Robotistan/REX-8in1-V2/README.md

# What is REX 8 in 1? 🤖🔍🌟

🤖 REX is an educational robot kit developed by Robotistan R&D team. The 8in1 robot kit, with its motherboard using the ESP32 infrastructure, eliminates the difficulties encountered in circuit setup such as port and cable confusion. However, Arduino IDE, Thonny IDE, and MicroBlocks IDE provide the user with great flexibility in programming. 🛠️🔌🚀

🎛️ The REX card is a special card designed to make the mechanical and electronic installation of the robots in the 8 in 1 set more convenient. This board, which uses the ESP32E processor, has connectors to easily connect all the components used in the REX 8 in 1 set to the circuit with a single cable. 🛠️🔌🤝🔗

⚙️ 4 motor drivers and servo motors connectors to make the installation and circuit designs of 8 in 1 robots easier on the REX board, 1 connection connector for each to connect the HC-SR04, IR, and MPU6050 sensors, to connect a 9v battery to the circuit externally port and 1 buzzer and switch integrated into the card. 🛠️🔌🏎️🎛️🚀🔋🔊

🔌💡🔋🔊 Enjoy building and programming your robots with REX! Happy robot adventures! 🚀🌟🤖🎉

<div align="">
  
</div>

## Repository Contents

- ##### [Components](https://github.com/Robotistan/8in1/tree/main/Components)
   * [Line-IR Follower Sensor](https://github.com/Robotistan/8in1/tree/main/Components/Line-IR%20Follower%20Sensor)
   * [REX Pinout/Main](https://github.com/Robotistan/REX-8in1-V2/tree/main/REX%20Pinout)
   * [E-Book](https://github.com/Robotistan/REX-8in1-V2/files/12227503/QUICK.START.GUIDE.pdf)
- #### [Installation Manuals](https://github.com/Robotistan/8in1/tree/main/Installation%20Manuals)
- ##### [Robots](https://github.com/Robotistan/8in1/tree/main/Robots) 🤖
   * [ArmBot](https://github.com/Robotistan/REX-8in1-V2/tree/main/Robots%20%26%20Code/REX_Main_V5/ArmBot) 
   * [BalanceBot](https://github.com/Robotistan/REX-8in1-V2/tree/main/Robots%20%26%20Code/REX_Main_V5/BalanceBot)
   * [OmniBot](https://github.com/Robotistan/REX-8in1-V2/tree/main/Robots%20%26%20Code/REX_Main_V5/OmniBot)
   * [RoverBot](https://github.com/Robotistan/REX-8in1-V2/tree/main/Robots%20%26%20Code/REX_Main_V5/RoverBot)
   * [SonicBot](https://github.com/Robotistan/REX-8in1-V2/tree/main/Robots%20%26%20Code/REX_Main_V5/SonicBot)
   * [SumoBot](https://github.com/Robotistan/REX-8in1-V2/tree/main/Robots%20%26%20Code/REX_Main_V5/SumoBot)
   * [TrackerBot](https://github.com/Robotistan/REX-8in1-V2/tree/main/Robots%20%26%20Code/REX_Main_V5/TrackerBot)
   * [WiBot](https://github.com/Robotistan/REX-8in1-V2/tree/main/Robots%20%26%20Code/REX_Main_V5/WiBot)
- ##### [Usage of ESP32 with Arduino IDE](https://github.com/Robotistan/8in1/tree/main/Usage%20of%20ESP32%20With%20Arduino%20IDE)
   * [Troubleshooting](https://github.com/Robotistan/8in1/tree/main/Usage%20of%20ESP32%20With%20Arduino%20IDE/Troubleshooting)

| Click on the 🤖 robot images to jump to the robot's page! 🔍🚀 | Enjoy exploring the robots! 🤩🔎🤖🌟 |
|---|---|
| Resim 1 | Resim 2 |
| [Arm Bot](https://github.com/Robotistan/REX-8in1-V2/tree/main/Robots%20%26%20Code/REX_Main_V5/ArmBot) | [Omni Bot](https://github.com/Robotistan/REX-8in1-V2/tree/main/Robots%20%26%20Code/REX_Main_V5/OmniBot) |
| Resim 3 | Resim 4 |
| [Balance Bot](https://github.com/Robotistan/REX-8in1-V2/tree/main/Robots%20%26%20Code/REX_Main_V5/BalanceBot) | [Rover Bot](https://github.com/Robotistan/REX-8in1-V2/tree/main/Robots%20%26%20Code/REX_Main_V5/RoverBot) |
| Resim 5 | Resim 6 |
| [Arm Bot](https://github.com/Robotistan/REX-8in1-V2/tree/main/Robots%20%26%20Code/REX_Main_V5/ArmBot) | [Sumo Bot](https://github.com/Robotistan/REX-8in1-V2/tree/main/Robots%20%26%20Code/SumoBot) |
| Resim 1 | Resim 8 |
| [Tracker Bot](https://github.com/Robotistan/REX-8in1-V2/tree/main/Robots%20%26%20Code/REX_Main_V5/TrackerBot) | [Wi Bot](https://github.com/Robotistan/REX-8in1-V2/tree/main/Robots%20%26%20Code/REX_Main_V5/WiBot) |

<h1 align="center">Ask Me Anything! 🎉</h1>

<div align="center">
  
</div>

<p align="center">
  <b>Welcome to the Best GitHub File! This file is open for you to ask any kind of questions. Feel free to ask your questions!</b>
  <br>
  <sub>I'm looking forward to your excellent questions and inspiring answers!</sub>
</p>

<br>

## 🚀 How Can I Ask a Question?

To ask a question, follow these steps:

1. Take a general look at this project, as your question might already be answered.
2. Go to the [Issues](https://github.com/Robotistan/REX-8in1-V2/issues) section and click on the "New Issue" button.
3. Provide a descriptive title and details for your question.
4. If applicable, add tags to make it easier for others to find your question.
5. Finally, click on the "Submit New Issue" button to post your question.

## 🤖 What Type of Questions Can I Ask?

This repository is open for asking any type of questions related to the project. Here are some examples:

- How to do something?
- How can I contribute to the project?
- I found a bug, how can I report it?
- I want to propose a new feature, what should I do?

If you have any further questions or need assistance, feel free to reach out to us via email at: <a href="mehmetali.dag@robotistan.com">💌 mehmetali.dag@robotistan.com</a>

## License

* Apache License

All original source code in this repository is Copyright (C) 2022 REX/Robotistan. This source code is licensed under the Apache License 2.0 as described in the file LICENSE.
Licensed under the Apache License, Version 2.0 (the "License");
you may not use this file except in compliance with the License.
You may obtain a copy of the License at

    http://www.apache.org/licenses/LICENSE-2.0

 Unless required by applicable law or agreed to in writing, software
 distributed under the License is distributed on an "AS IS" BASIS,
 WITHOUT WARRANTIES OR CONDITIONS OF ANY KIND, either express or implied.
 See the License for the specific language governing permissions and
 limitations under the License.

<p align="center">
  animated
</p>

## Authors ve Appreciation
For Design and Development of REX GitHuB Page by;
- [@ozerngg](https://github.com/ozerngg) 
- [@mehmetalidag97](https://github.com/mehmetalidag97) 

## Note
If you have any questions, please contact technical support on our [Robotistan Community](https://community.robotistan.com/).
