Robotistan/REX-8in1-V2/REX IDE Firmware/readme.txt

+-----------------------------------------+
|            Robotistan INC - 2024        |
+-----------------------------------------+

+-----------------------------------------+
|               ENGLISH (EN)              |
+-----------------------------------------+
Welcome to the Robotistan INC flashing tool! This tool allows you to easily flash MicroPython onto your ESP32 or REX Board.

1- Connect your ESP32: Plug your ESP32 or REX Board into your computer via USB.
2- Run the uploadFirmware.bat file: Double-click the .bat file to run it.
3- Select your COM port: When prompted, type the COM port (for example: COM3).
4- The tool will automatically erase the flash and write MicroPython to your device.
	- If you see the message "Failed to get PID of a device on COM*, using standard reset sequence." 
	and dots keep appearing continuously ("...."), press and hold the "BOOT" button on your device and 
	try again to upload the firmware.
5- Once done, the process is complete!

That's it! You’re ready to start using MicroPython on your ESP32!

Important Notes:
Windows Warning: If a Windows warning appears when you run the .bat file, click More Info and then click Run Anyway to proceed with the flashing process.
COM Port not detected: If you don't see your device in the COM port list, you may need to install the CH340 driver. Run the CH341SER.EXE file and click Install to install the necessary drivers.

+-----------------------------------------+
|               TURKISH (TR)              |
+-----------------------------------------+
Robotistan INC programlama aracına hoş geldiniz! Bu araç, MicroPython'u ESP32 veya REX Board'unuza kolayca yüklemenizi sağlar.

1- ESP32'nizi bağlayın: ESP32 veya REX Board'unuzu USB aracılığıyla bilgisayarınıza takın.
2- .bat dosyasını çalıştırın: uploadFirmware.bat dosyasına çift tıklayarak çalıştırın.
3- COM portunuzu seçin: İstendiğinde, COM portunuzu yazın (örneğin: COM3).
4- Araç, flash'ı otomatik olarak silecek ve MicroPython'u cihazınıza yazacaktır.
	- Eğer "Failed to get PID of a device on COM*, using standard reset sequence." mesajını görürseniz 
	ve noktalar sürekli olarak ekranda beliriyorsa ("...."), cihazınızdaki "BOOT" tuşuna basılı tutarak 
	yazılımı tekrar yüklemeyi deneyin.
5- İşlem tamamlandığında, işlem tamamlanmış olur!

Hepsi bu kadar! Artık ESP32'nizde MicroPython kullanmaya hazırsınız!

Önemli Notlar:
Windows Uyarısı: Eğer bat dosyasını çalıştırırken bir Windows uyarısı görürseniz, Daha Fazla Bilgi kısmına tıklayın ve ardından Yine de Çalıştır seçeneğine tıklayarak işlemi devam ettirin.
COM Portu Görünmüyorsa: Cihazınızı COM portları listesinde göremiyorsanız, CH340 sürücüsünü yüklemeniz gerekebilir. CH341SER.EXE dosyasını çalıştırarak Install tuşuna basarak sürücüyü yükleyebilirsiniz.

+-----------------------------------------+
|               GERMAN (DE)               |
+-----------------------------------------+

Willkommen beim Robotistan INC Flash-Tool! Mit diesem Tool können Sie MicroPython ganz einfach auf Ihr ESP32 oder REX Board flashen.

1- **Verbinden Sie Ihr ESP32**: Schließen Sie Ihr ESP32 oder REX Board über USB an Ihren Computer an.  
2- **Führen Sie die uploadFirmware.bat-Datei aus**: Doppelklicken Sie auf die .bat-Datei, um sie auszuführen.  
3- **Wählen Sie Ihren COM-Port aus**: Wenn Sie dazu aufgefordert werden, geben Sie den COM-Port ein (z. B. COM3).  
4- Das Tool löscht automatisch den Flash und schreibt MicroPython auf Ihr Gerät.  
	- Wenn Sie die Nachricht "Failed to get PID of a device on COM*, using standard reset sequence." sehen und 
	Punkte ständig erscheinen (**"...."**), halten Sie die **"BOOT"**-Taste auf Ihrem Gerät gedrückt und 
	versuchen Sie erneut, die Firmware hochzuladen.
5- Sobald der Vorgang abgeschlossen ist, ist der Prozess abgeschlossen!

Das war's! Sie sind bereit, MicroPython auf Ihrem ESP32 zu verwenden!

Wichtige Hinweise:
Windows-Warnung: Wenn beim Ausführen der .bat-Datei eine Windows-Warnung angezeigt wird, klicken Sie auf Weitere Informationen und dann auf Trotzdem ausführen, um mit dem Flashvorgang fortzufahren.
COM-Port nicht erkannt: Wenn Sie Ihr Gerät nicht in der Liste der COM-Ports sehen, müssen Sie möglicherweise den CH340-Treiber installieren. Führen Sie die CH341SER.EXE-Datei aus und klicken Sie auf Installieren, um die erforderlichen Treiber zu installieren.

+-----------------------------------------+
|               SPANISH (ES)              |
+-----------------------------------------+

¡Bienvenido a la herramienta de flash de Robotistan INC! Esta herramienta te permite flashear fácilmente MicroPython en tu ESP32 o REX Board.

1- Conecta tu ESP32: Conecta tu ESP32 o REX Board a tu computadora a través de USB.
2- Ejecuta el archivo .bat: Haz doble clic en el archivo uploadFirmware.bat para ejecutarlo.
3- Selecciona tu puerto COM: Cuando se te pida, escribe el puerto COM (por ejemplo: COM3).
4- La herramienta borrará automáticamente el flash y escribirá MicroPython en tu dispositivo.
	- Si ves el mensaje "Failed to get PID of a device on COM*, using standard reset sequence." 
	y los puntos siguen apareciendo continuamente ("...."), mantén presionado el botón "BOOT" 
	en tu dispositivo y vuelve a intentar cargar el firmware.
5- Una vez finalizado, ¡el proceso está completo!

¡Eso es todo! ¡Estás listo para empezar a usar MicroPython en tu ESP32!

Notas Importantes:
Advertencia de Windows: Si aparece una advertencia de Windows al ejecutar el archivo .bat, haz clic en Más información y luego en Ejecutar de todos modos para continuar con el proceso de flasheo.
No se detecta el puerto COM: Si no ves tu dispositivo en la lista de puertos COM, es posible que necesites instalar el controlador CH340. Ejecuta el archivo CH341SER.EXE y haz clic en Instalar para instalar los controladores necesarios.

+-----------------------------------------+
|               FRENCH (FR)               |
+-----------------------------------------+
Bienvenue dans l'outil de flash de Robotistan INC ! Cet outil vous permet de flasher facilement MicroPython sur votre ESP32 ou REX Board.

1- Connectez votre ESP32 : Branchez votre ESP32 ou REX Board à votre ordinateur via USB.
2- Exécutez le fichier uploadFirmware.bat : Double-cliquez sur le fichier .bat pour l'exécuter.
3- Sélectionnez votre port COM : Lorsque vous êtes invité, tapez le port COM (par exemple : COM3).
4- L'outil effacera automatiquement le flash et écrira MicroPython sur votre appareil.
	- Si vous voyez le message "Failed to get PID of a device on COM*, using standard reset sequence." 
	et que des points apparaissent en continu ("...."), maintenez le bouton "BOOT" de votre appareil 
	enfoncé et réessayez de télécharger le firmware.
5- Une fois terminé, le processus est complet !

C'est tout ! Vous êtes prêt à commencer à utiliser MicroPython sur votre ESP32 !

Notes Importantes:
Avertissement Windows : Si un avertissement Windows apparaît lorsque vous exécutez le fichier .bat, cliquez sur Plus d'informations puis cliquez sur Exécuter quand même pour continuer le processus de flashage.
Port COM non détecté : Si vous ne voyez pas votre appareil dans la liste des ports COM, vous devrez peut-être installer le pilote CH340. Exécutez le fichier CH341SER.EXE et cliquez sur Installer pour installer les pilotes nécessaires.

+-----------------------------------------+
|               KAZAKH (KZ)               |
+-----------------------------------------+
Robotistan INC құралымен флеш жасауға қош келдіңіз! Бұл құрал MicroPython жүйесін ESP32 немесе REX Board құрылғыңызға оңай орнатуға мүмкіндік береді.

1- ESP32 құрылғысын қосыңыз: ESP32 немесе REX Board құрылғыңызды USB арқылы компьютеріңізге қосыңыз.
2- uploadFirmware.bat файлын іске қосыңыз: .bat файлына екі рет басып іске қосыңыз.
3- COM портыңызды таңдаңыз: Көрсетілгенде COM портын теріңіз (мысалы: COM3).
4- Құрал флешті автоматты түрде өшіріп, MicroPython-ды құрылғыңызға жазып береді.
	- Егер "Failed to get PID of a device on COM*, using standard reset sequence." 
	хабарын көрсеңіз және нүктелер үздіксіз пайда болса ("...."), құрылғыңыздағы "BOOT" 
	түймесін басып тұрып, firmware жазуды қайтадан бастаңыз.
5- Барлық процесс аяқталған соң, жұмыс аяқталды!

Бұл болды! Енді ESP32-де MicroPython қолдануға дайынсыз!

Маңызды Ескертулер:
Windows Хабарламасы: Бат файлды іске қосқан кезде Windows хабарламасы шықса, Қосымша Ақпарат-қа басыңыз және Әлі де іске қосу деп, флеш жасау процесін жалғастырыңыз.
COM портын көрмесеңіз: Құрылғыңызды COM порттар тізімінде көрмесеңіз, CH340 драйверін орнату қажет болуы мүмкін. CH341SER.EXE файлын іске қосып, Install түймесін басу арқылы драйверді орнатуға болады.

+-----------------------------------------+
|               TURKMEN (TM)              |
+-----------------------------------------+
Robotistan INC flashlama gurallaryna hoş geldiňiz! Bu gural, MicroPython'y ESP32 ýa-da REX Board'ınıza aňsatlyk bilen ýazyp biler.

1- ESP32'nizi baglaň: ESP32 ýa-da REX Board'yňyzy USB arkaly kompýuteriňize baglaň.
2- uploadFirmware.bat faýlını işlediň: .bat faýlanyň üstüne iki gezek basyp işlediň.
3- COM portunuzu saýlaň: Soňra COM portuňyzy ýazmagyňyzy haýyş edýäris (mysal üçin: COM3).
4- Gural flash'ı awtomatiki arassalar we MicroPython'u enjamyňyza ýazýar.
	- Eger "Failed to get PID of a device on COM*, using standard reset sequence." habaryny görseňiz 
	we nokatlar yzygiderli peýda bolsa ("...."), enjamyňyzdaky "BOOT" düwmesini basyp, 
	programma ýazmagy täzeden synanyşyp bilersiňiz.
5- Tamamlandy, işiňiz tamam!

Şeýle! Indi ESP32-de MicroPython ulanmak üçin taýýar!

Eýranly Notlar:
Windows Uýarmasy: Eger bat faýlını işlediýän wagtyňyz Windows uýarmasy ýüze çyksa, Has giňişleýin maglumat-a basyň we Halaçyla işlediň diýip, işlemi dowam etdiriň.
COM Porty Görünmese: Cihazyňyzy COM portlary sanawynda görmeseňiziň sebäbi CH340 sürücüsini yüklemek gerek bolup biler. CH341SER.EXE faýlını işlediň we Install düwmesine basyp sürüjini yükleýşiňizi dowam etdiriň.
