Robotistan/REX-8in1-V2/Robots & Code/README.md

rex_version
