Robotistan/REX-8in1-V2/PicoBricksGo App/README.md

# PicoBricks Go App
app _qr_kodlar
* When you select the "REX 8 in 1" option from the main menu, you will be directed to this menu where the list of REX robots is displayed. From this menu, you can choose the REX robot you want to use.
menu1
* You can use this button to control the Wi-Bot.

menu2
* You can use this button to control the OmniBot.

menu3

* You can use this button to control the ArmBot.

menu7

* REX 8in1 gamepad screen.

menu12

* Click this button to access the REX consoles.

menu4

* You can use this button to return to the previous menu.

menu5

* You can use this button to disconnect or connect.

menu6

* You can use this button to reset the robotic arm's servo motors (bring them to their default angles).

menu10

* You can use this button to activate the buzzer on the REX board and emit an audible alert (horn).

menu9

* If you want to control the REX using a joystick, you can use this area.

menu8

* You can use this area to control the robotic arm's servo motors.

menu11
