Robotistan/REX-8in1-V2/Robots & Code/REX_Main_V5/BalanceBot/README.md

## BalanceBot
BalanceBot is a special robot that can stay in balance despite physical interventions thanks to the acceleration sensor on the REX board. You can use BalanceBot in situations where you need to carry objects in balance.

<p align="center">
  animated
</p>
