Robotistan/REX-8in1-V2/Robots & Code/REX_Main_V5/WiBot/README.md

## WiBot

<p align="center">
  animated
</p>

WiBot is a REX 8 in 1 robot that does not contain any extra sensors for autonomous driving and allows only remote control. After completing the installation of WiBot, you will not have any difficulties in the circuit setup. After connecting the 4 connector cables required for the motor to the REX board, you can perform tasks that require remote control by using the electronic features of the REX board and the mechanical features of the WiBot without adding any extra sensors to the circuit.
