Robotistan/REX-8in1-V2/Robots & Code/REX_Main_V5/OmniBot/README.md

# OmniBot

<p align="center">
  animated
</p>

Thanks to its special omni wheels, OmniBot provides easy access to every point without making any rotational movement. Using OmniBot, you can reach hard-to-reach any points very easily. This robot is designed to reach hard-to-reach spots.

<p align="center">
  animated
</p>

Omni wheels combines the freedom of 360 degree movement with the stability of a fixed mounting. This is achieved through a design which uses integral rollers rather than a swivel mount. 
In this way, OmniBot provides advantages such as 360° maneuverability, better directional control-following and precise positioning.
