Robotistan/REX-8in1-V2/Robots & Code/REX_Main_V5/TrackerBot/README.md

## TrackerBot

<p align="center">
  animated
</p>

Thanks to the TrackerBot line follower sensor, it emits infrared lights and follows the black lines in the environment. We can autonomously enable TrackerBot to perform the tasks we want by using the mechanical features of the TrackerBot on the path we have created with lines. We can also change the color of the line TrackerBot follows by making changes to the code. In order to make this change, we can examine the values detected by the infrared sensor, determine the required value range for the color we want, and change these values in the code.
