Robotistan/REX-8in1-V2/Robots & Code/REX_Main_V5/SumoBot/README.md

## SumoBot
<p align="center">
  animated
</p>
Thanks to its HC-SR04 distance sensor and line follower sensor, SumoBot detects other objects on the track it is in. Thanks to its line-following sensor, SumoBot detects whether it is inside the track and in this way carries the objects off the track.
