Robotistan/REX-8in1-V2/Robots & Code/REX_Main_V5/SonicBot/README.md

## SonicBot

<p align="center">
  animated
</p>

SonicBot detects objects by emitting sound waves around it thanks to the distance sensor on it and can perform different functions by using its mechanical properties according to the values it senses. You can avoid obstacles by using SonicBot. You can use SonicBot for tasks that require you to detect objects in the environment.
