Robotistan/REX-8in1-V2/Usage of ESP32 With Arduino IDE/README.md

## Usage of ESP32 With Arduino IDE
Because of its high processing power and useful functions, ESP32 is highly preferred among many microcontrollers and development boards. Let's learn how to use ESP32 and install the ESP32 library.

## Installing ESP32 in Arduino IDE
To install the ESP32 board in your Arduino IDE, follow the steps below.

- In Arduino IDE, go to File>Preferences



- Type the following into the "Additional Board Manager URLs" field

 | https://raw.githubusercontent.com/espressif/arduino-esp32/gh-pages/package_esp32_index.json |
 | ------------------------------------------------------------------------------------------- |

Untitledd

- Click the Boards Manager

arduinoboard

- Install ESP32 by clicking install button after searching for ESP32. It'll be ready in a few seconds.

ardubo

## Let's Test The Installation
Plug your ESP32 board to your computer after you open Arduino IDE and follow steps below.
- ##### Step 1

boarddoit

- ##### Step 2

ardcom

- ##### Step 3

ardexam

- ##### A new sketch opens in your Arduino IDE.

S

- ##### Press the Upload button
- ##### If everything went as expected, we'll see “Done uploading” message.

Screenshotfsdf 2023-02-09 141242

- ##### Open the Arduino IDE Serial Monitor at a baud rate of 115200.
