Robotistan/REX-8in1-V2/(threads)

Thread 1 (2025-01-09):

BalanceBot wont work

patchido, 2025-01-09:
So i built the balancebot, after that ran the calibration code and got the offsets.

and when uploading the code v4 and even v5 the serial monitor stays at

`DMP ready! Waiting for first interrupt...`

And wont do more.

serhankoral, 2025-02-21:
Will uou solve this problem?

Thread 2 (2025-04-06):

Dc motorlar çalışmıyor

dursunonat, 2025-04-06:
Merhaba, armbot kurulumu yaptım 2 gündür uğraşıyorum. Robot kol çalışıyor fakat dc motorlar çalışmıyor. Sorun nerde olabilir

serdardmrrr, 2025-05-19:
ESP32 KARTININ MODELİNİ 2.0.11 e çek öyle düzelicek
