Robotistan/REX-8in1-V2/Installation Manuals/TrackerBot.pdf

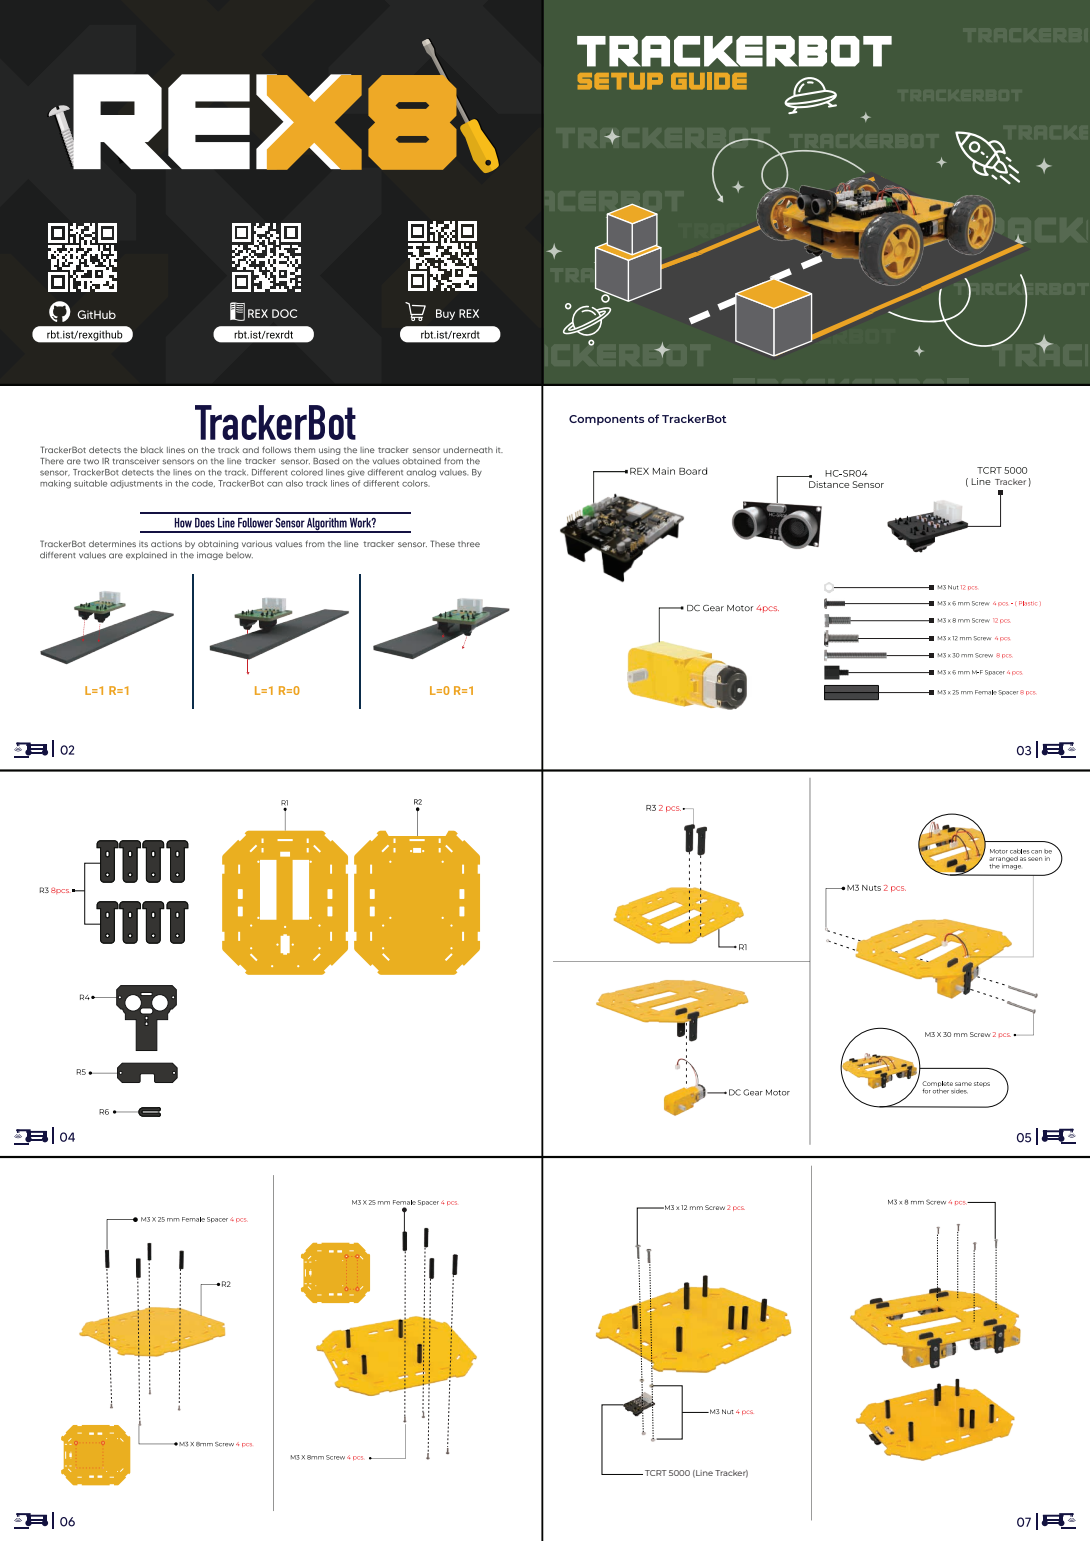
[picture p1: page 1]
tracker; Tracker

TCRT 5000 (Line Tracker)

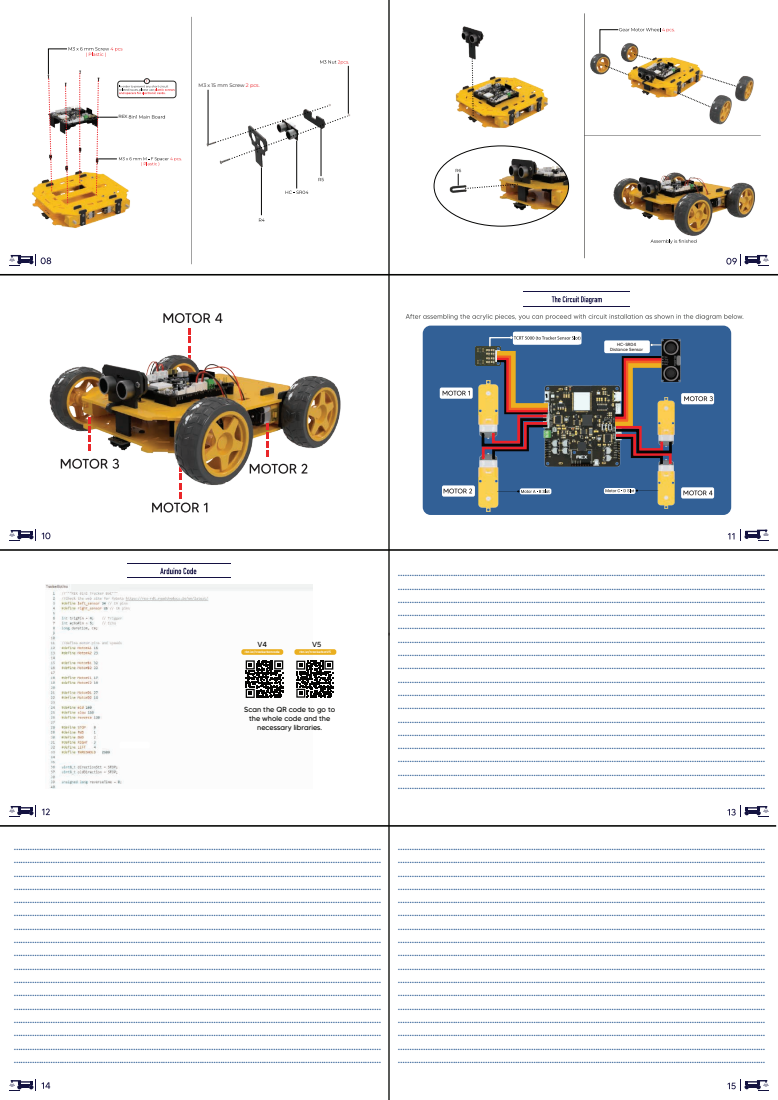
[picture p2: page 2]
HC-SR04 Distance Sensor; REX; rbt.ist/trackerbotcode; rbt.ist/trackerbotV5

M3 x 15 mm Screw 2 pcs.

Scan the QR code to go to
the whole code and the
necessary libraries.
