Robotistan/REX-8in1-V2/Installation Manuals/8in1_add_on.pdf

### 8n1 Add-on package ( Sumo & Tracker )

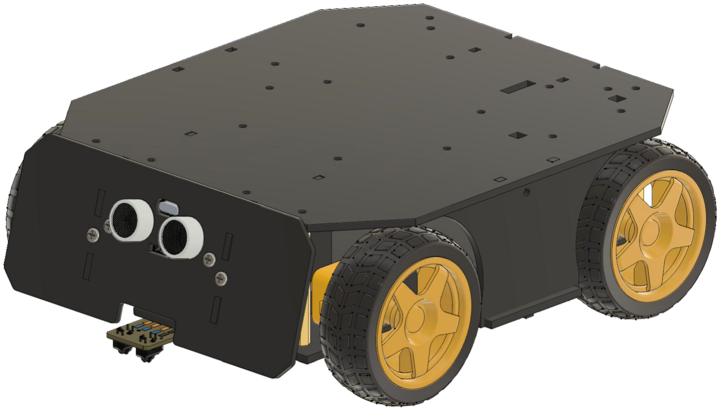
[picture p3: figure]
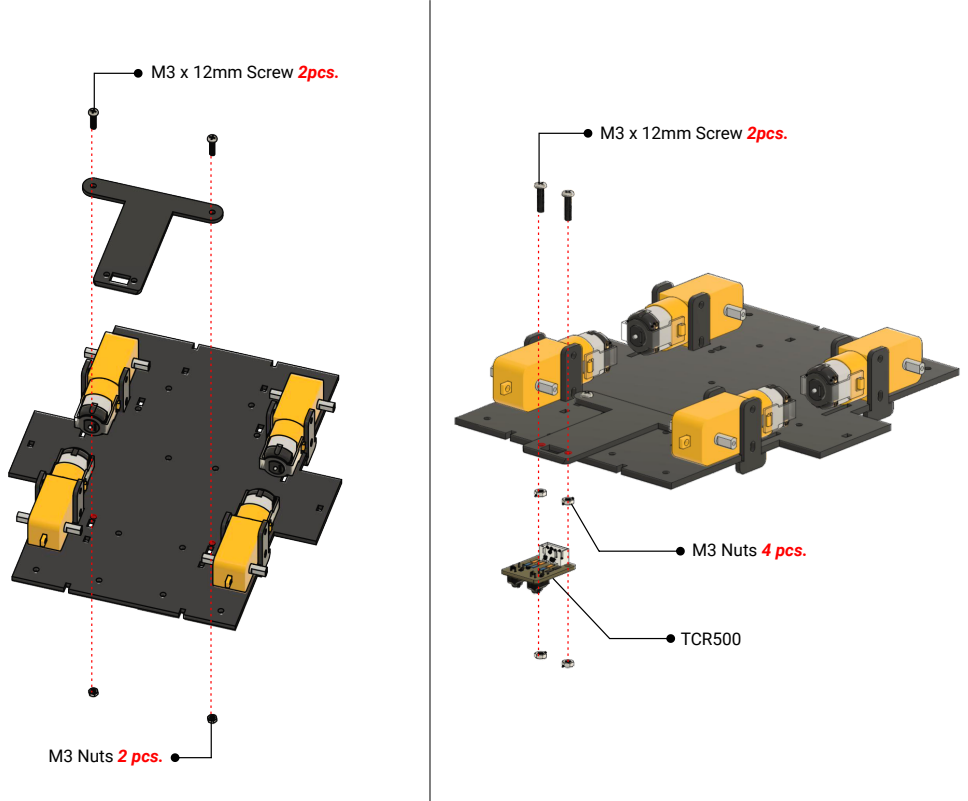
[picture p4: page 2]
M3 x 12mm Screw 2pcs.; M3 Nuts 2 pcs.; TCR500; M3 Nuts 4 pcs.

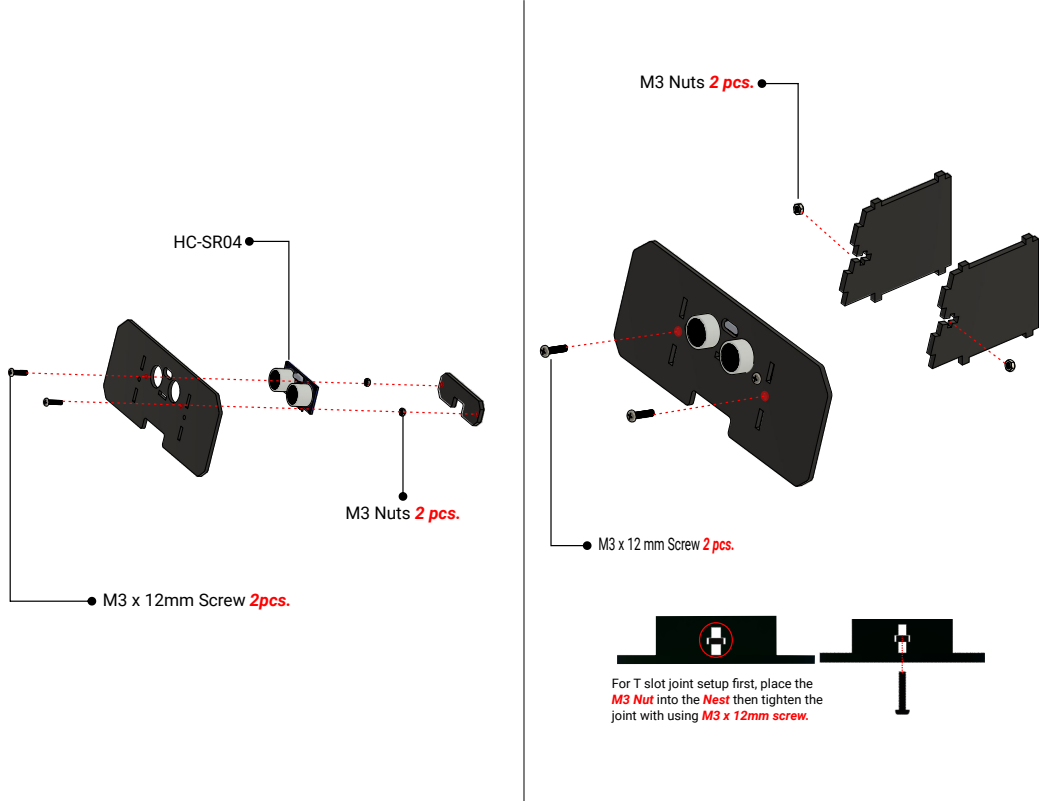
[picture p5: page 3]
M3 Nuts 2 pcs.; M3 x 12mm Screw 2pcs.

M3 x 12 mm Screw 2 pcs.

For T slot joint setup first, place the
M3 Nut into the Nest then tighten the
joint with using M3 x 12mm screw.

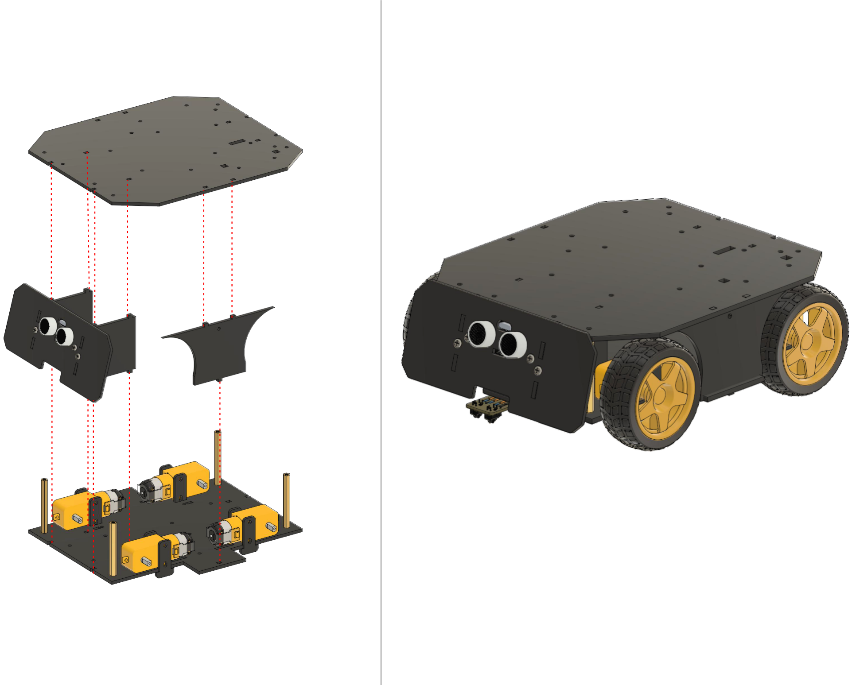
[picture p6: page 4]
