Robotistan/REX-8in1-V2/Installation Manuals/Installation-of-Omni-Wheel.pdf

# OMNI Wheel

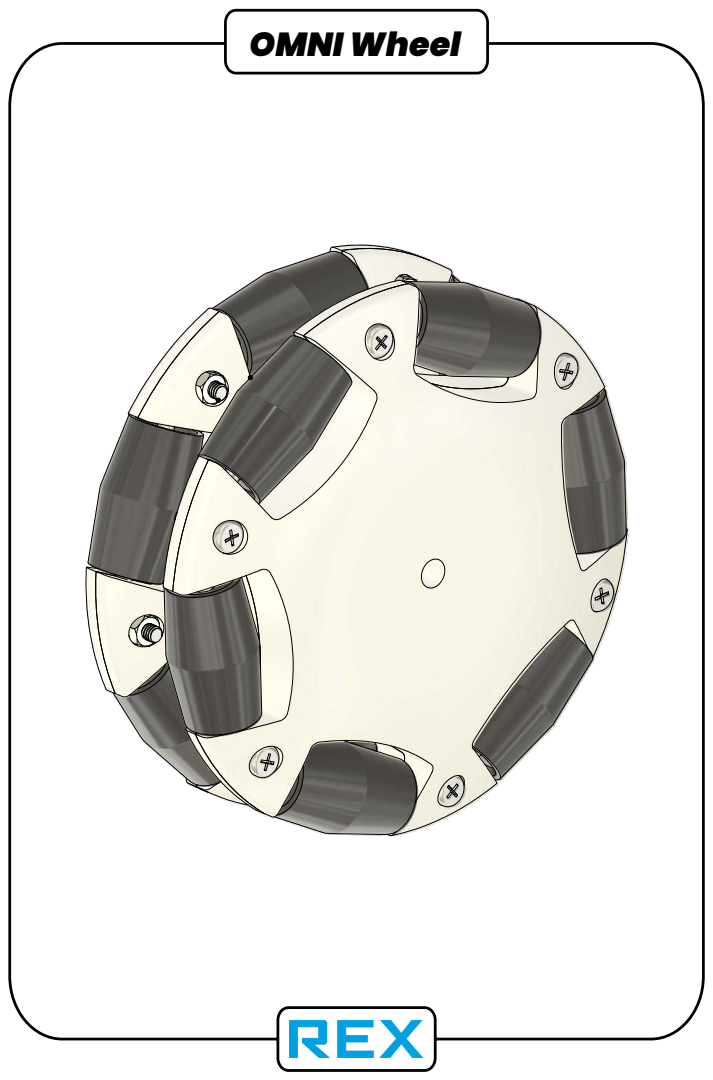
[picture p7: page 1]

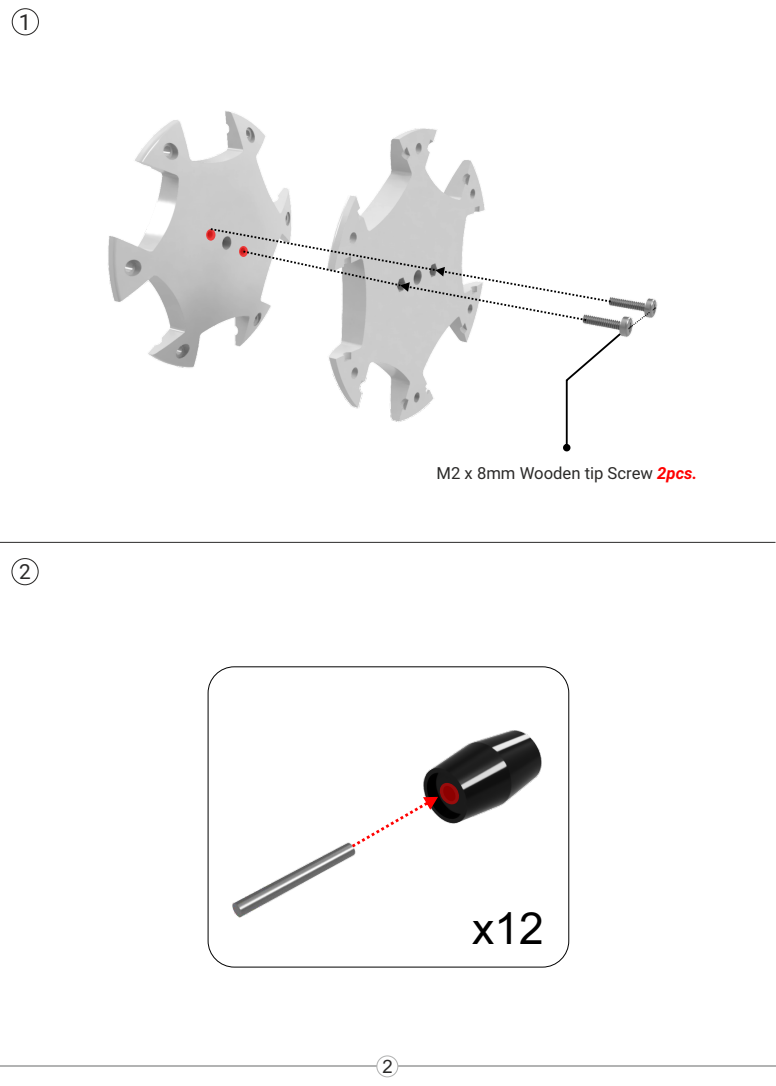
[picture p8: page 2]

M2 x 8mm Wooden tip Screw 2pcs.

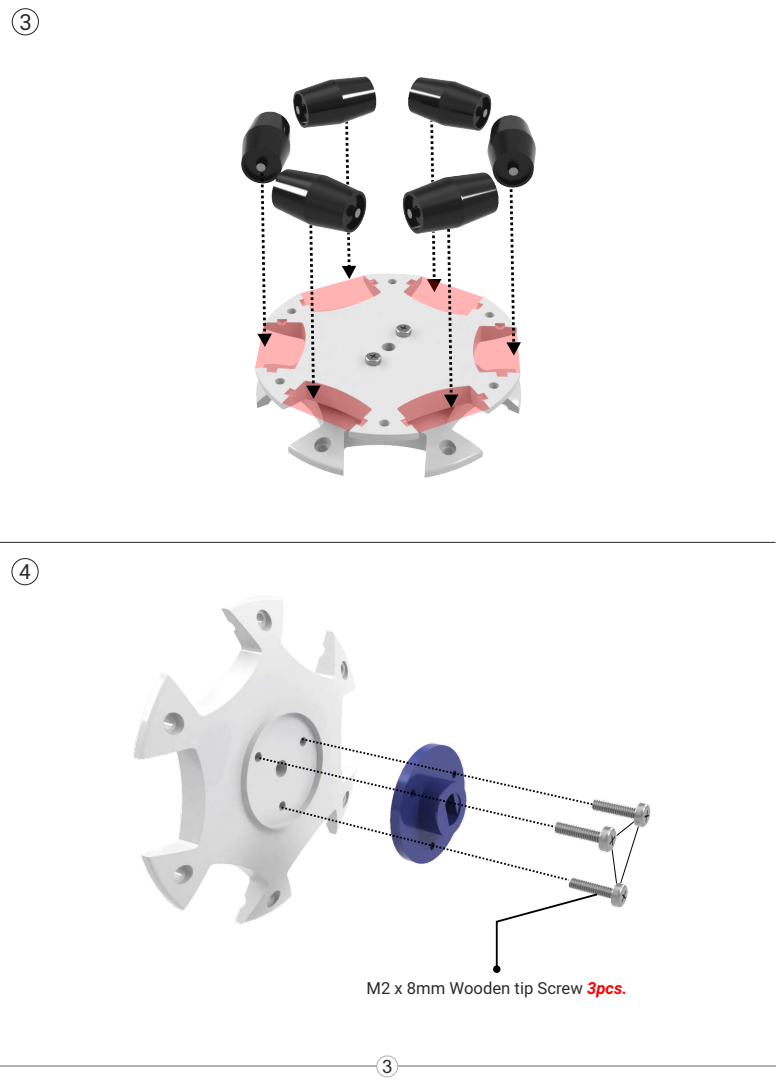
[picture p9: page 3]

M2 x 8mm Wooden tip Screw 3pcs.

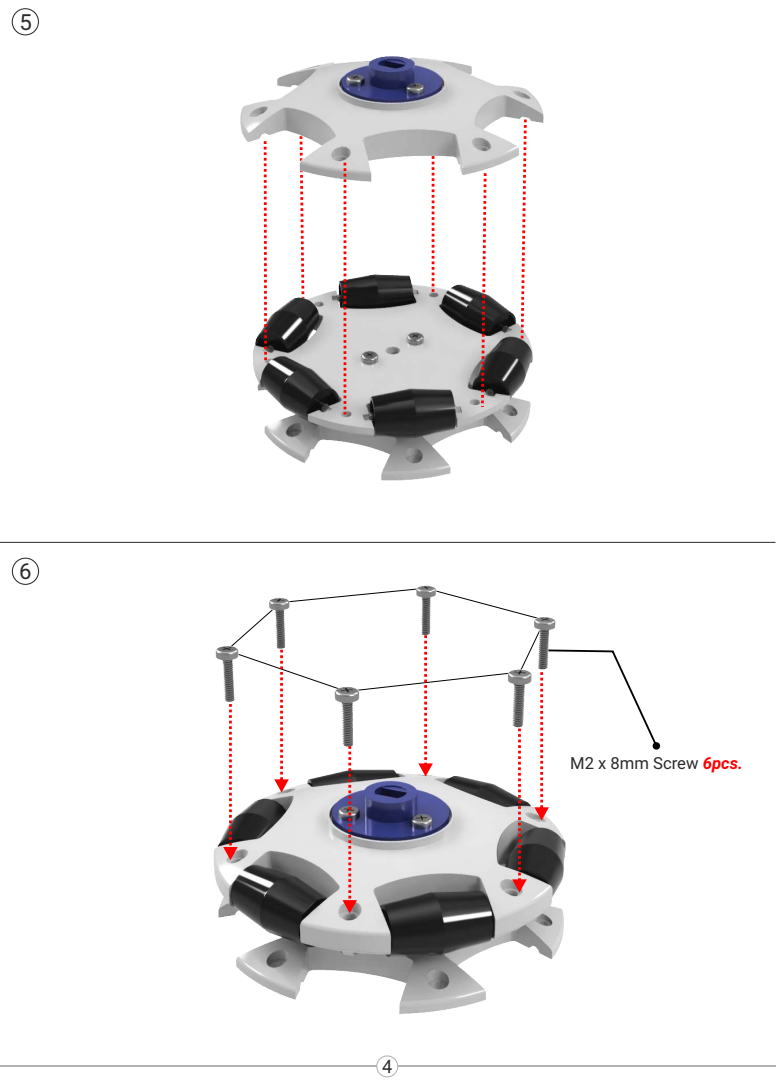
[picture p10: page 4]
M2 x 8mm Screw 6pcs.

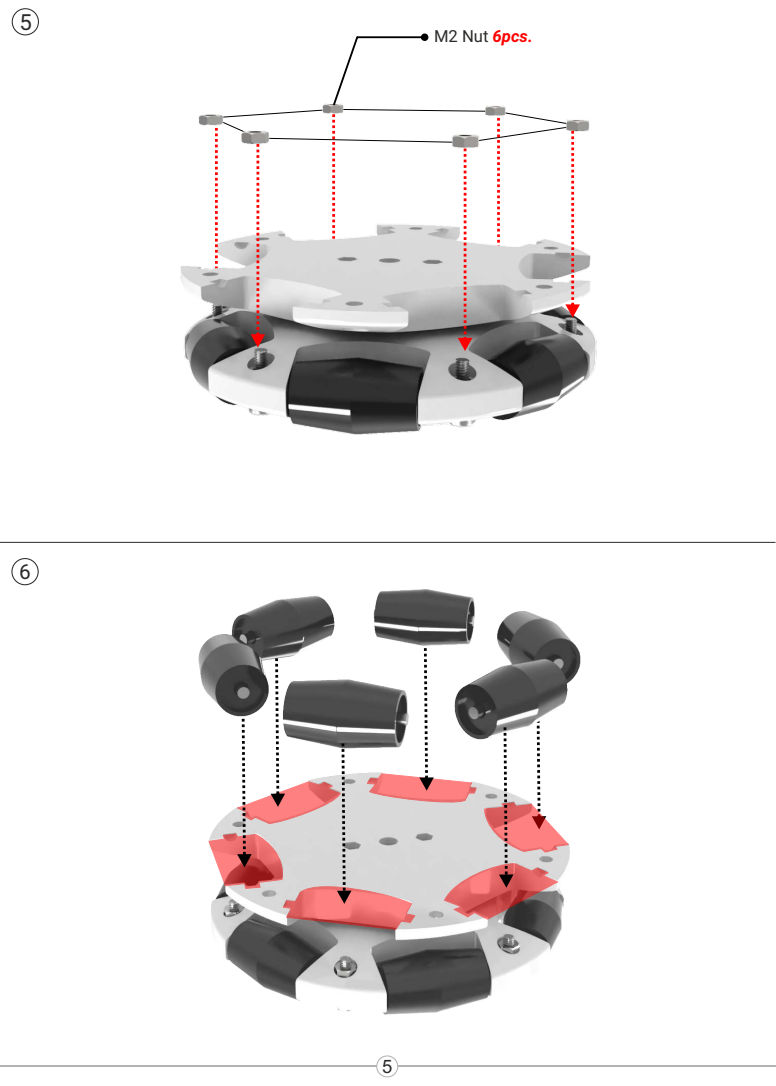
[picture p11: page 5]
M2 Nut 6pcs.

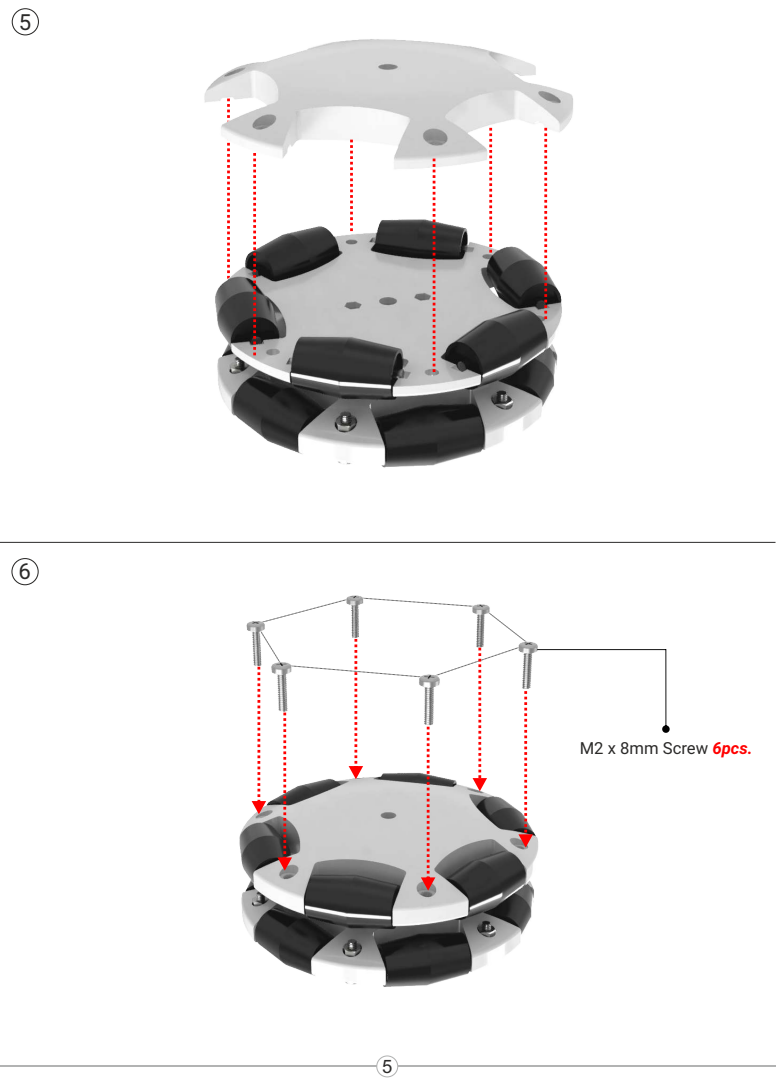
[picture p12: page 6]
M2 x 8mm Screw 6pcs.

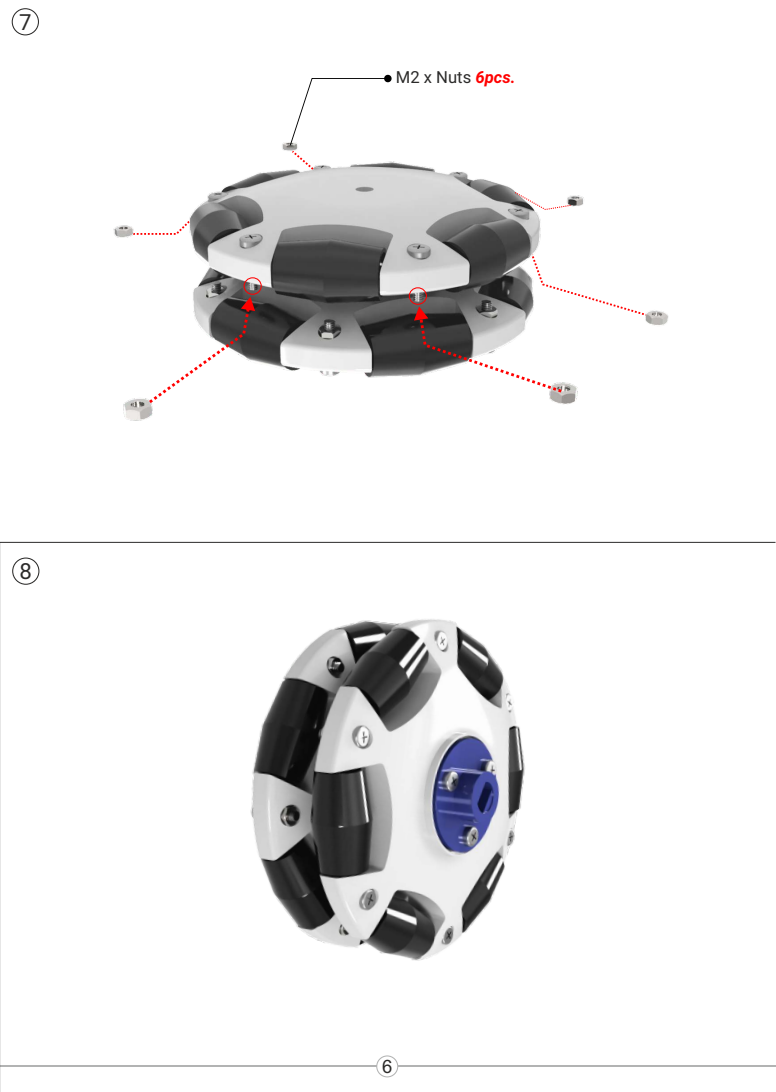
[picture p13: page 7]
M2 x Nuts 6pcs.
