Robotistan/REX-8in1-V2/Installation Manuals/BalanceBot.pdf

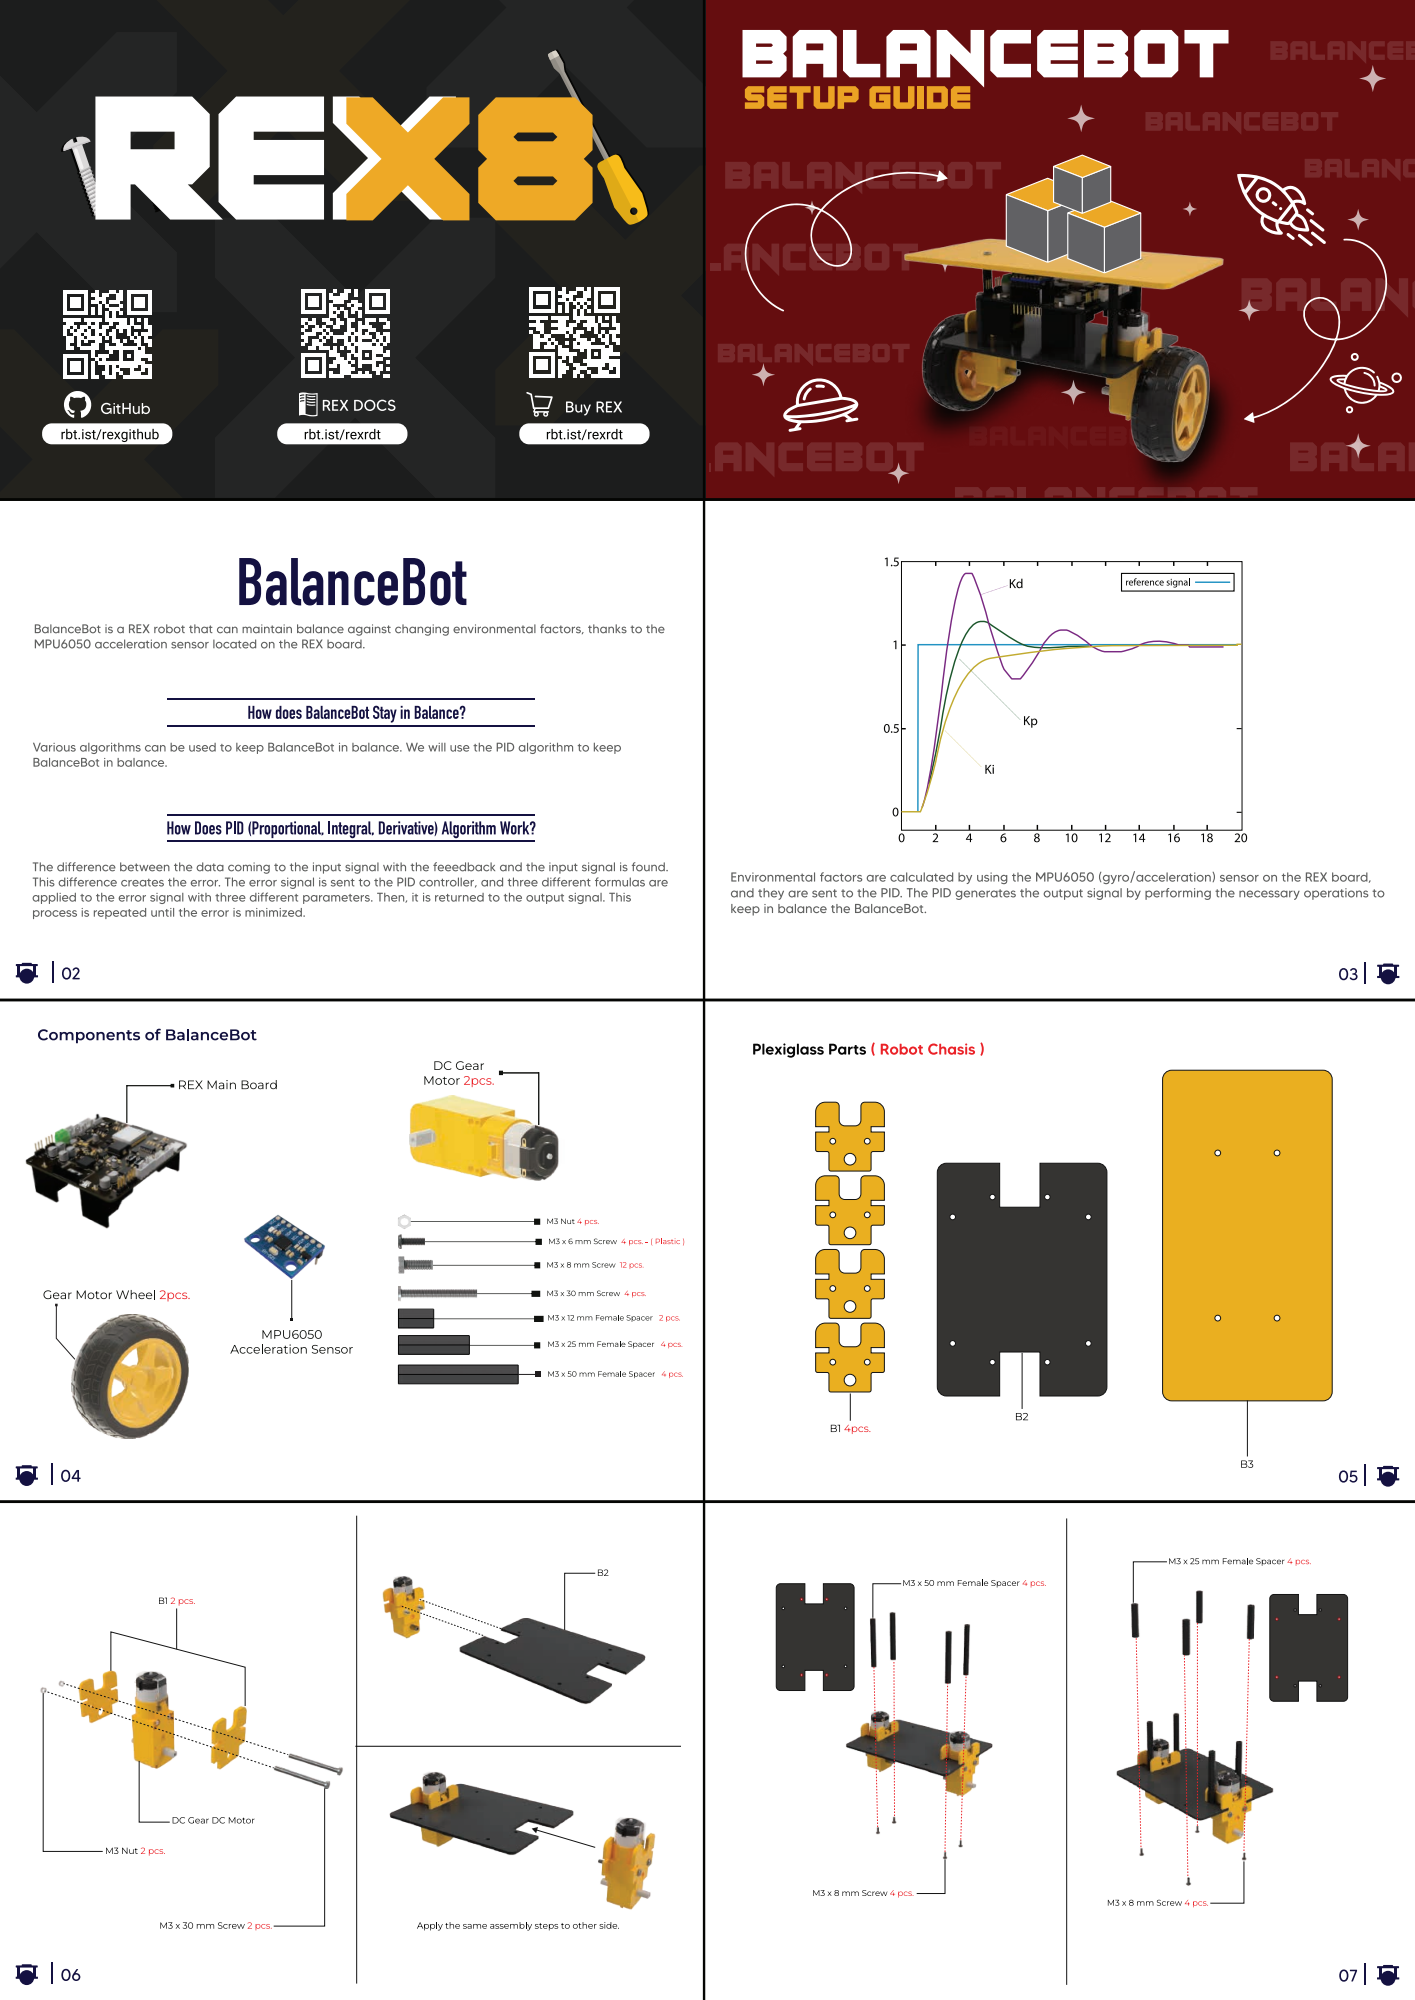
[picture p18: page 1]

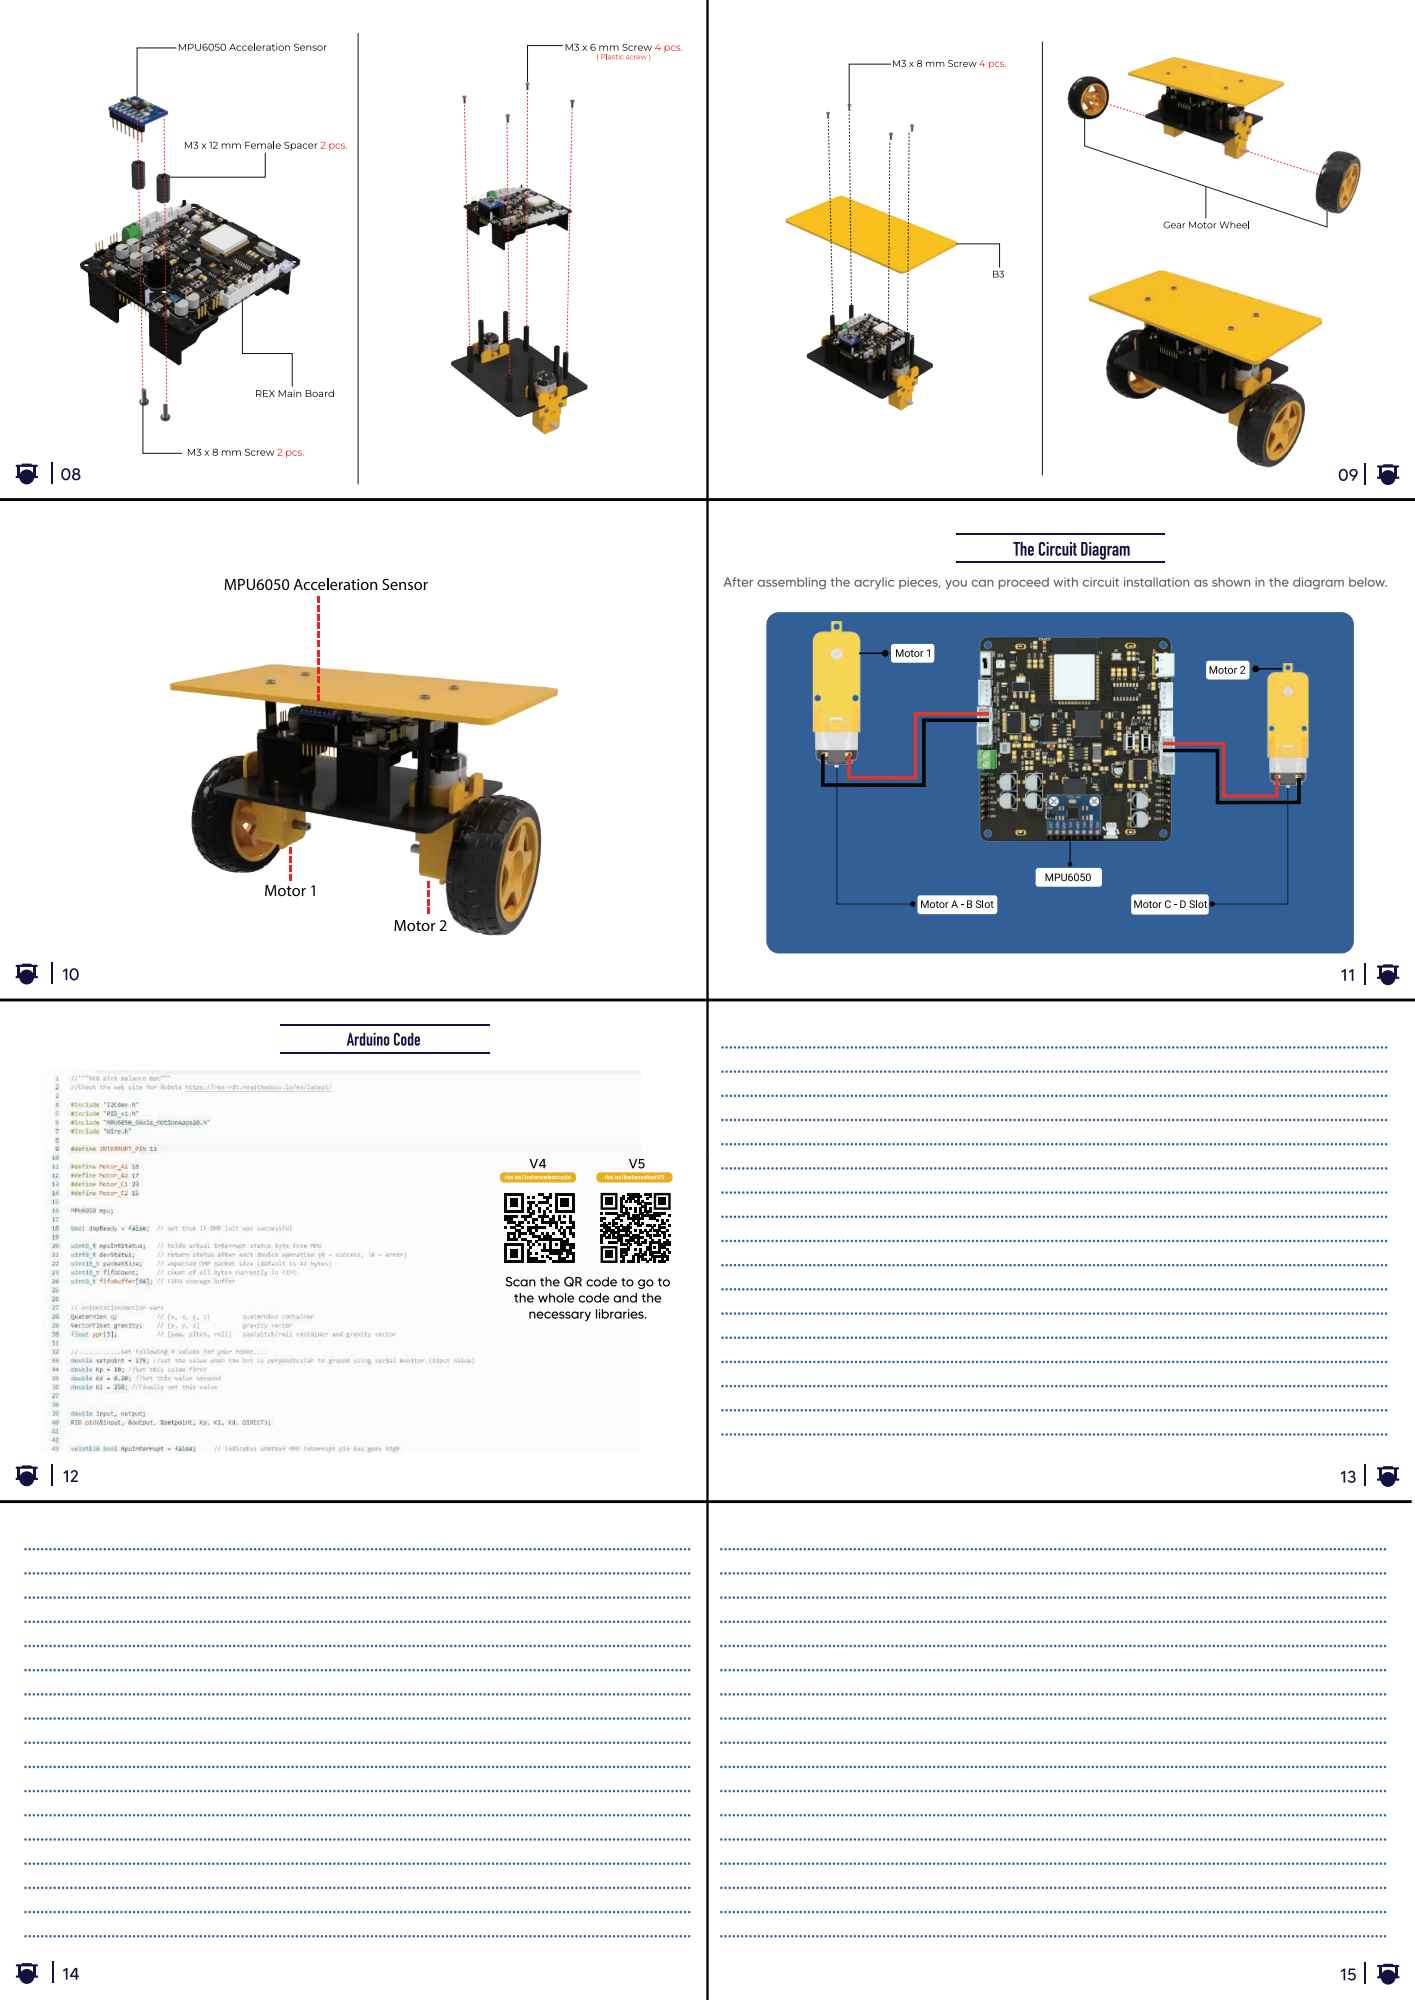
[picture p19: page 2]
