Robotistan/REX-8in1-V2/Installation Manuals/OmniBot.pdf

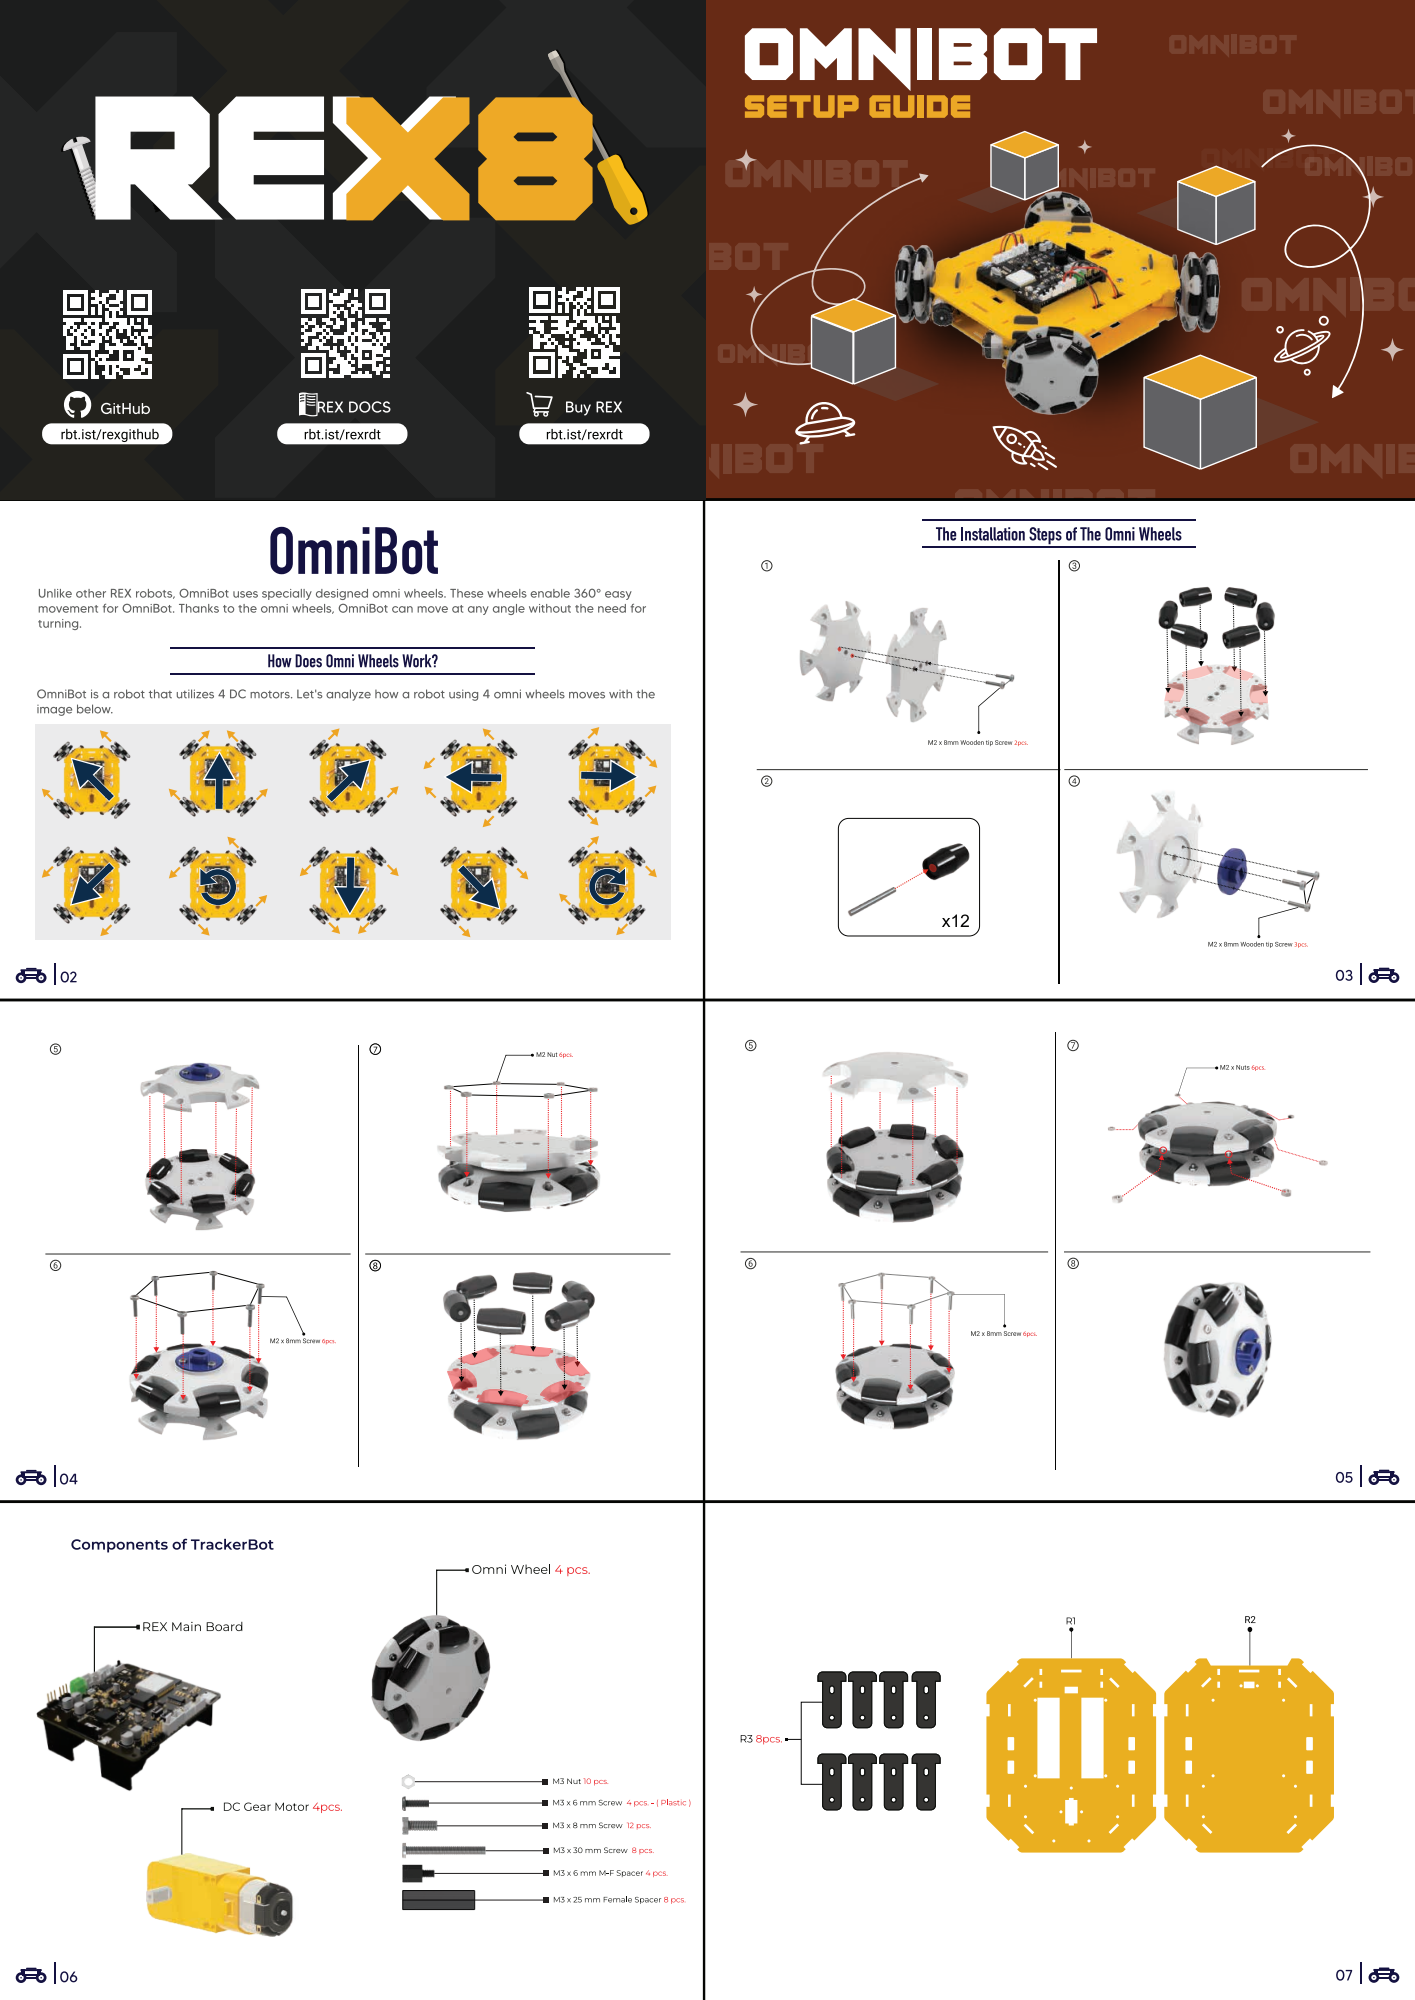
[picture p20: page 1]

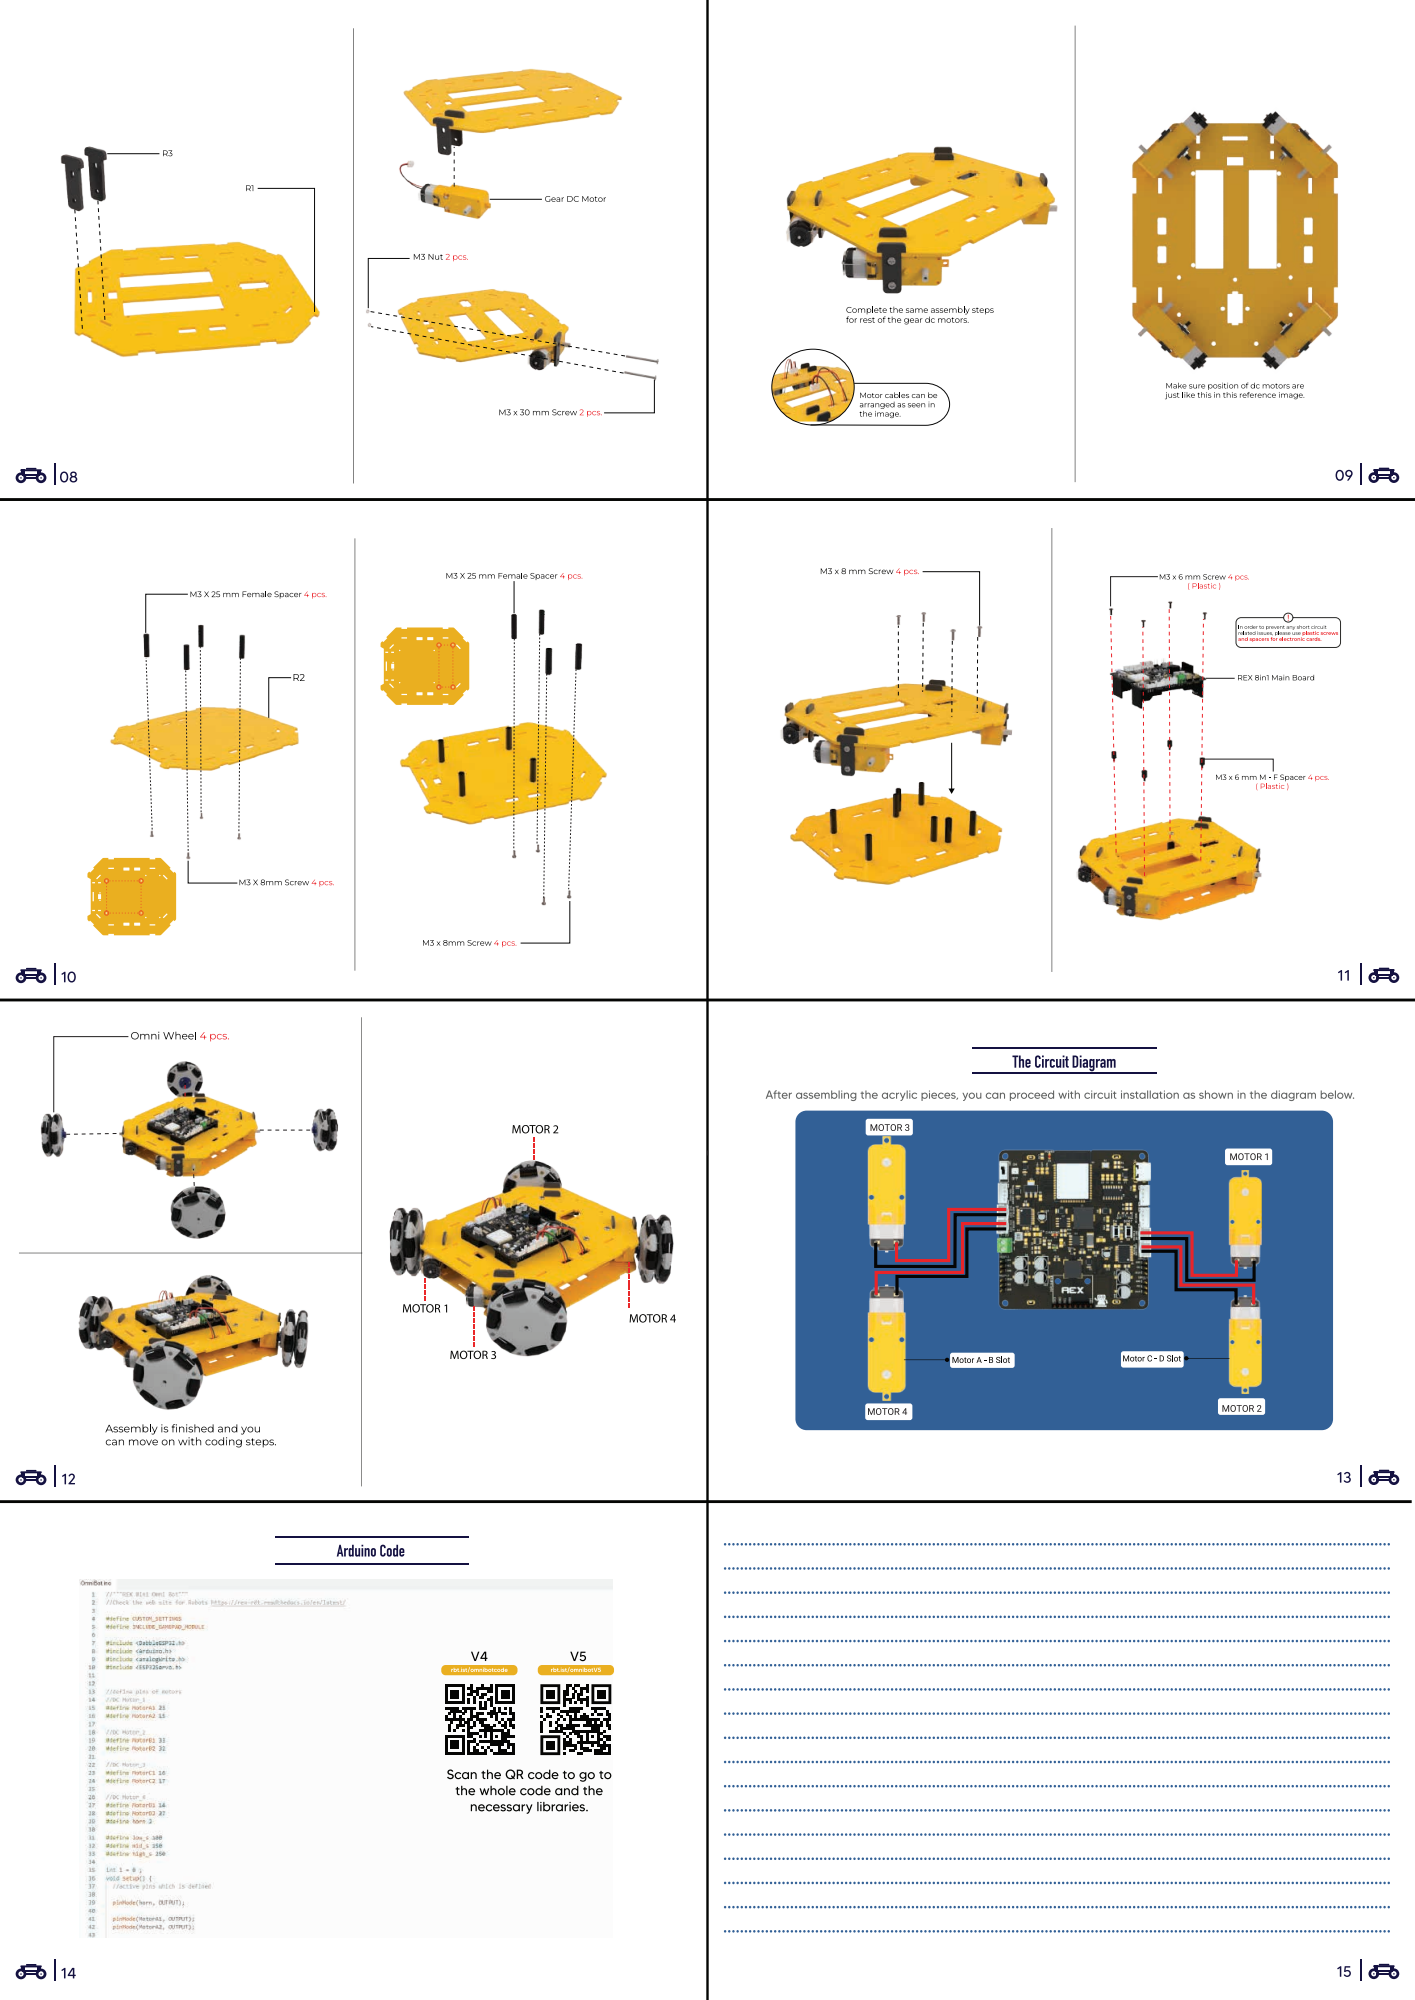
[picture p21: page 2]
