Robotistan/REX-8in1-V2/Installation Manuals/REX QUICK STARTER GUIDE.pdf

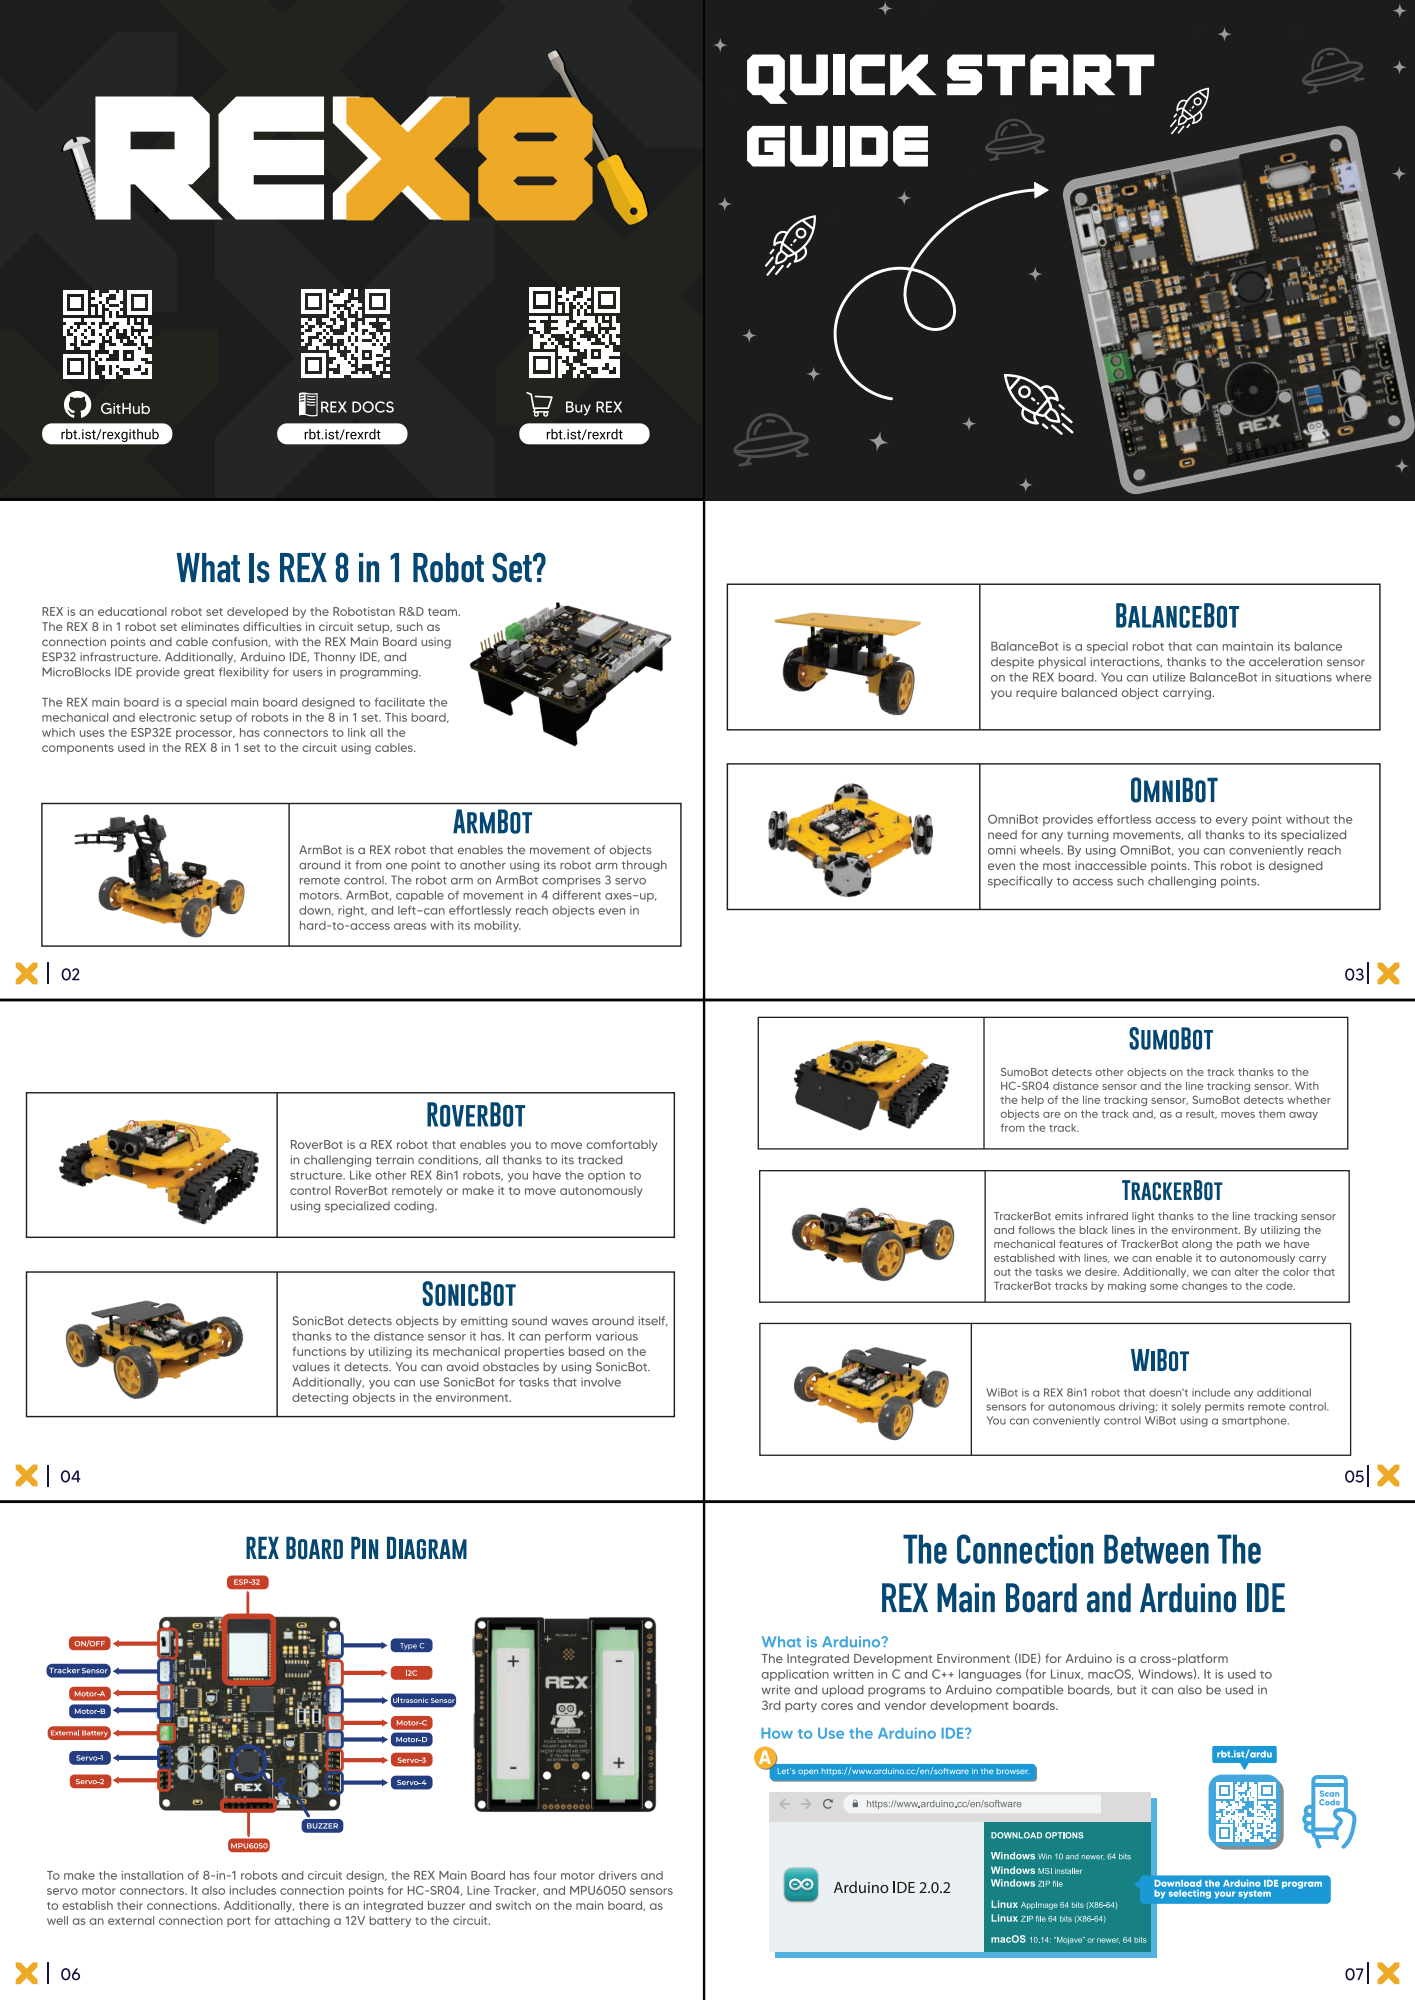
[picture p22: page 1]

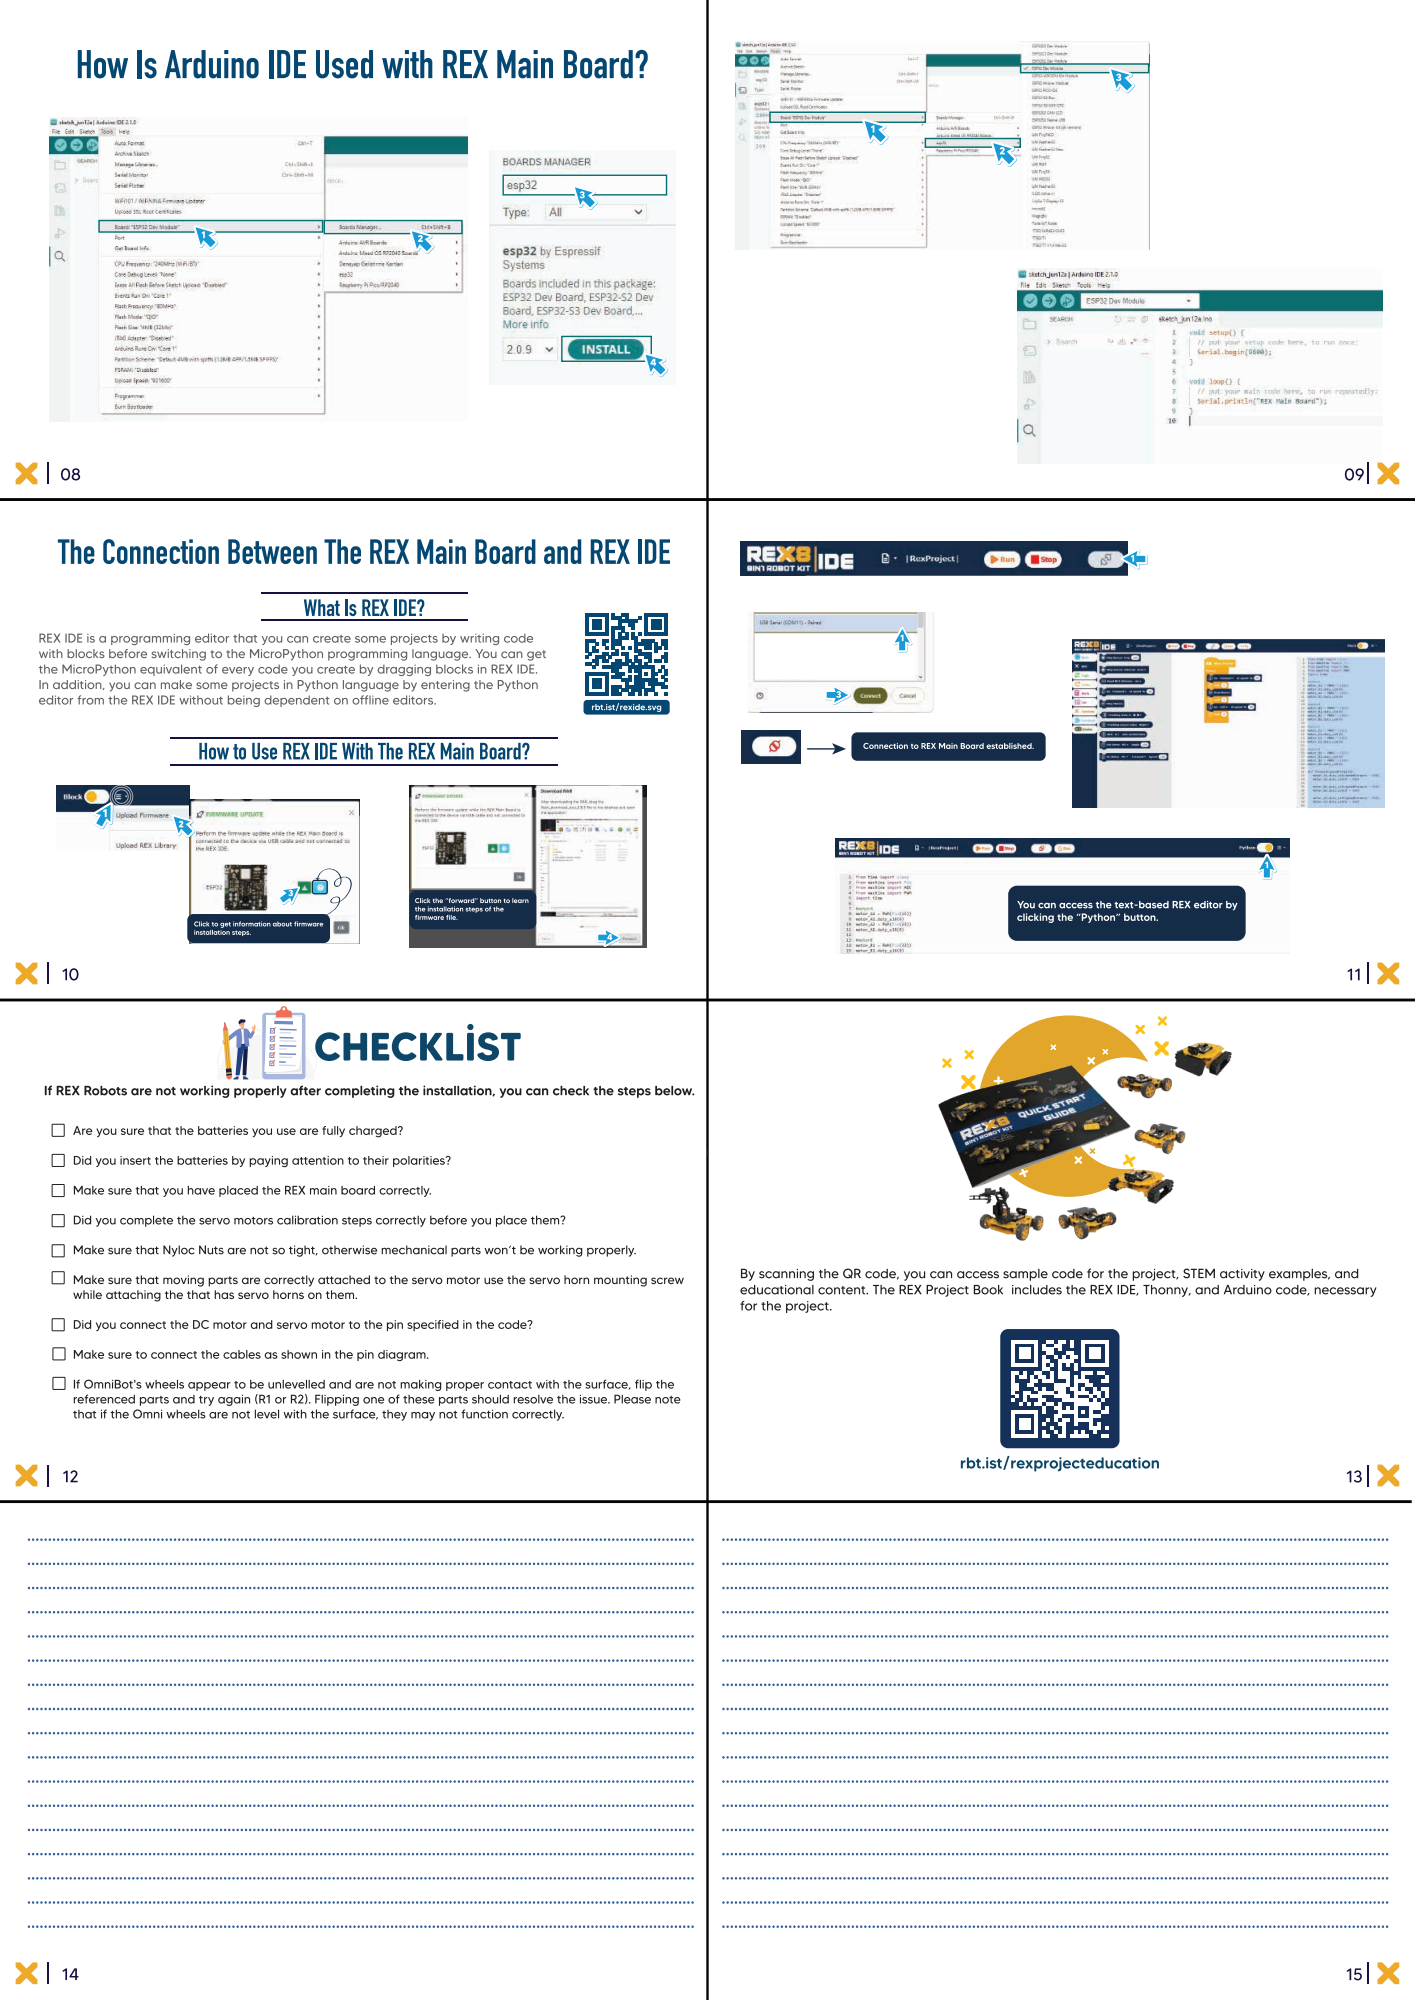
[picture p23: page 2]
