Robotistan/REX-8in1-V2/Installation Manuals/RoverBot.pdf

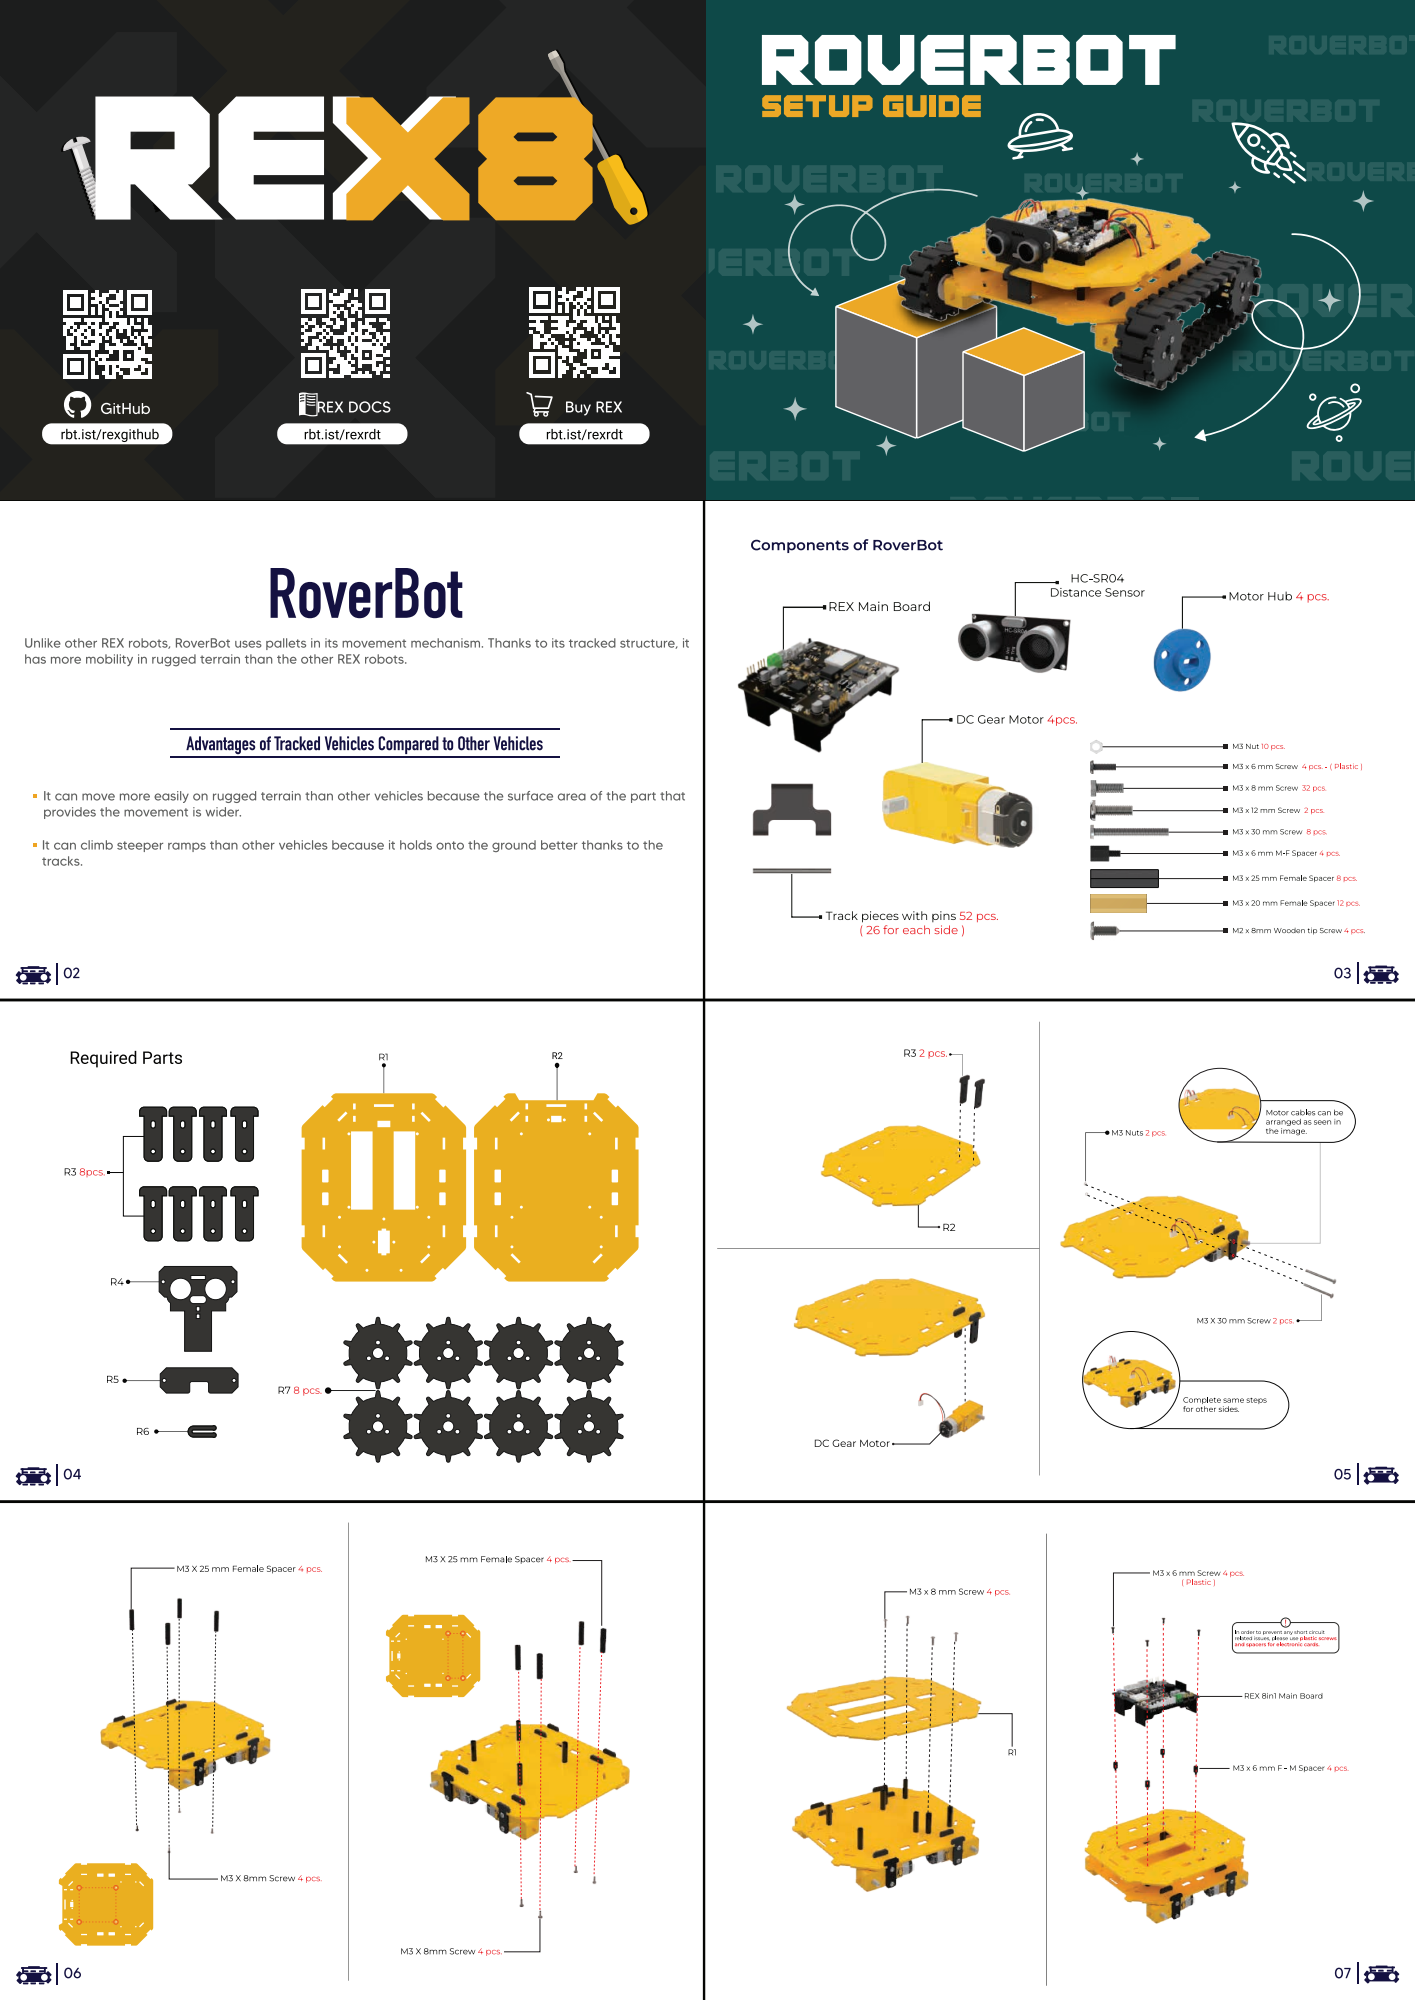
[picture p24: page 1]

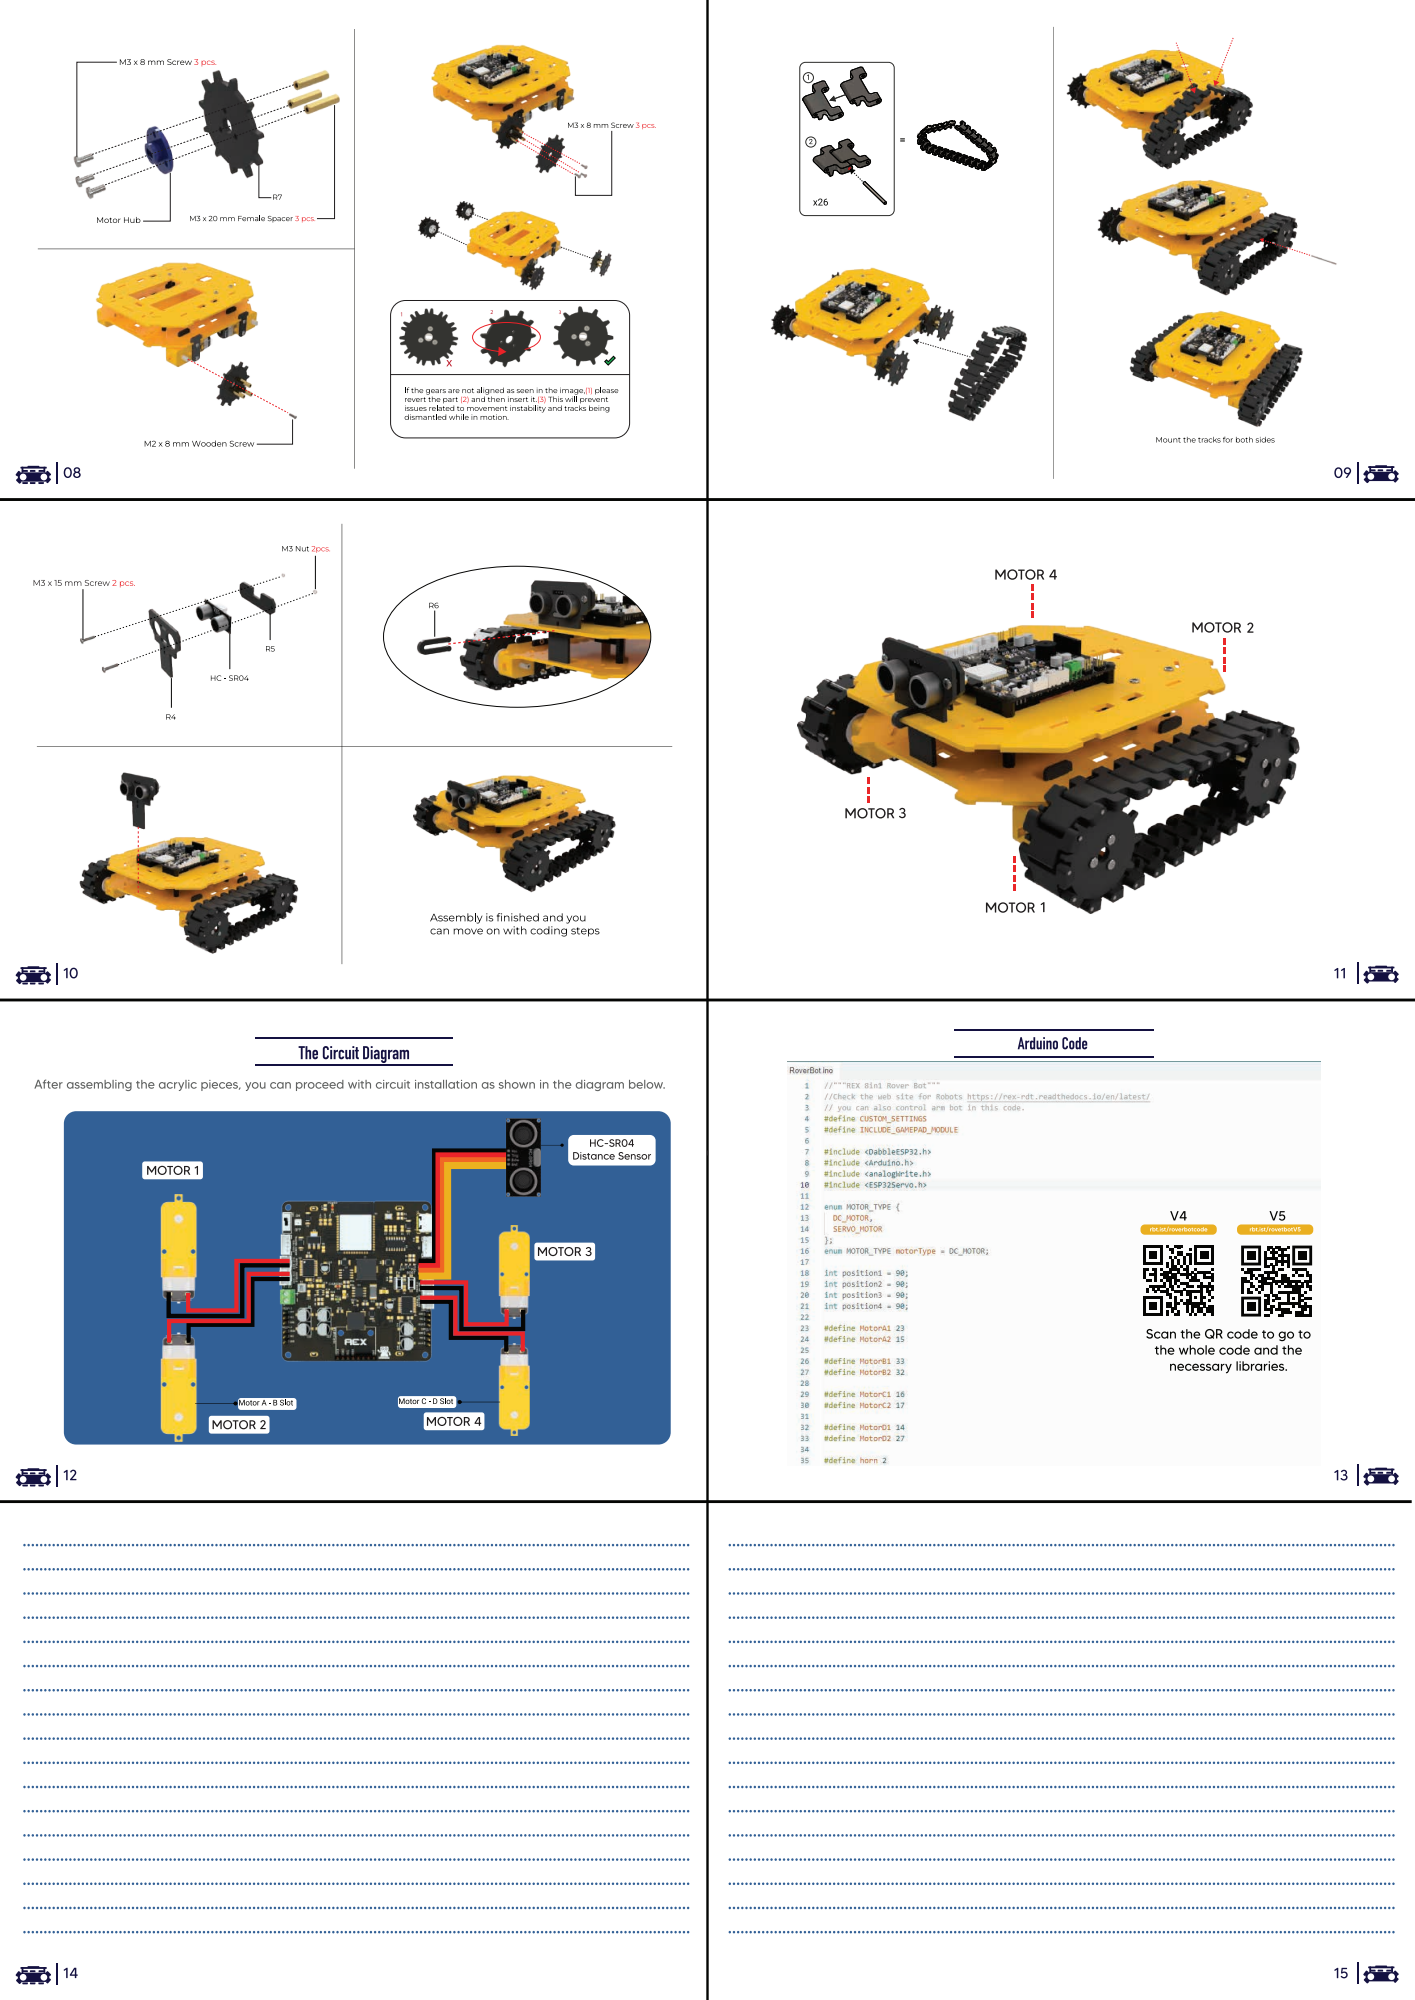
[picture p25: page 2]
