Robotistan/REX-8in1-V2/Installation Manuals/SonicBot.pdf

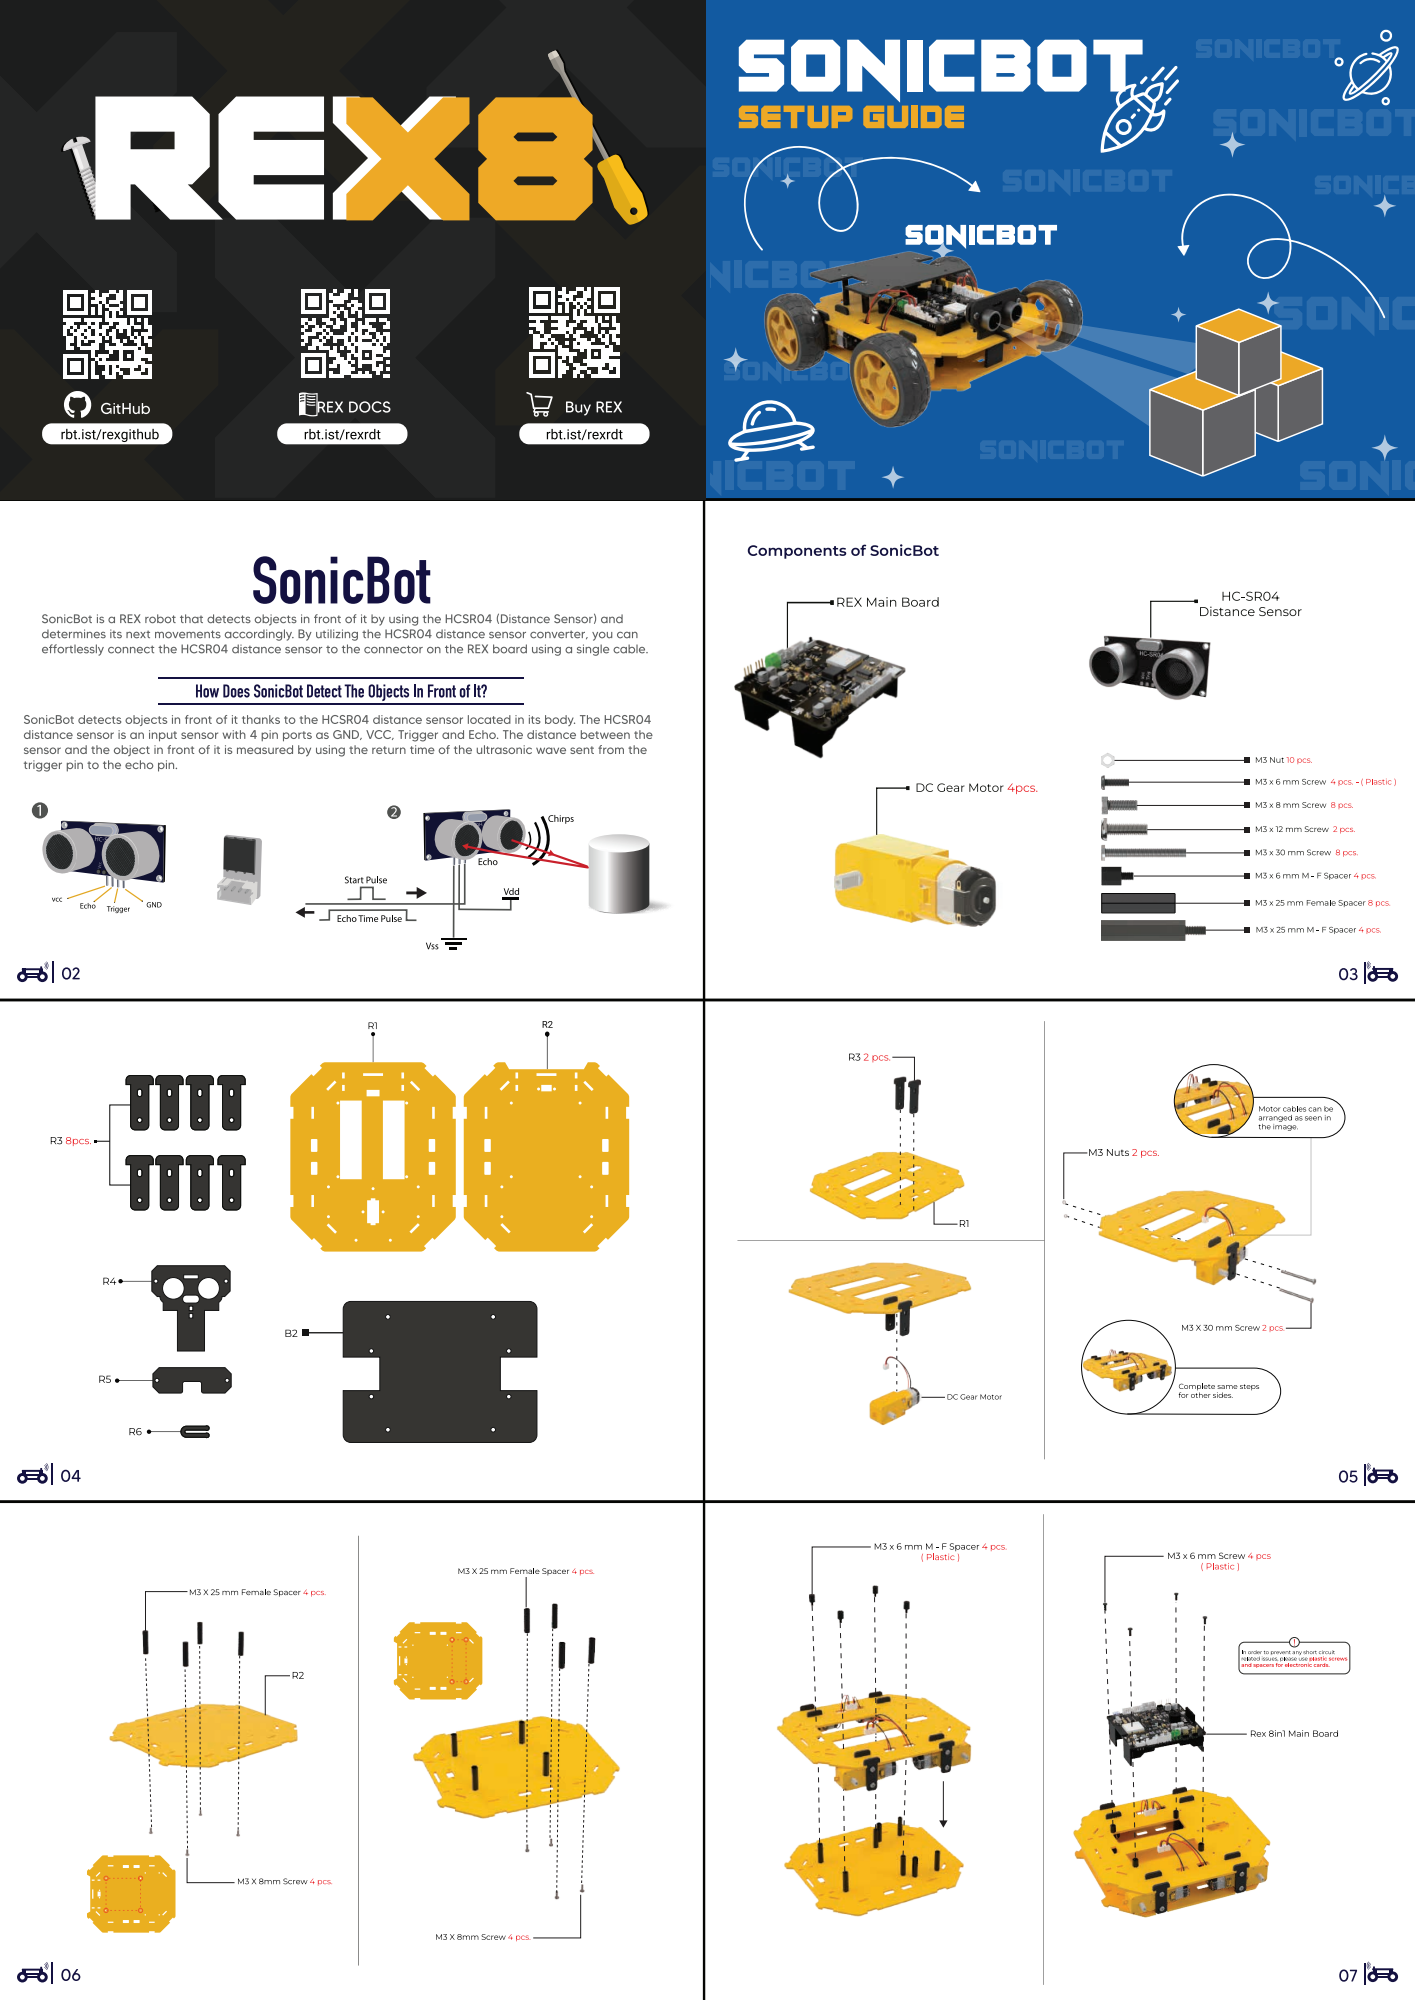
[picture p26: page 1]

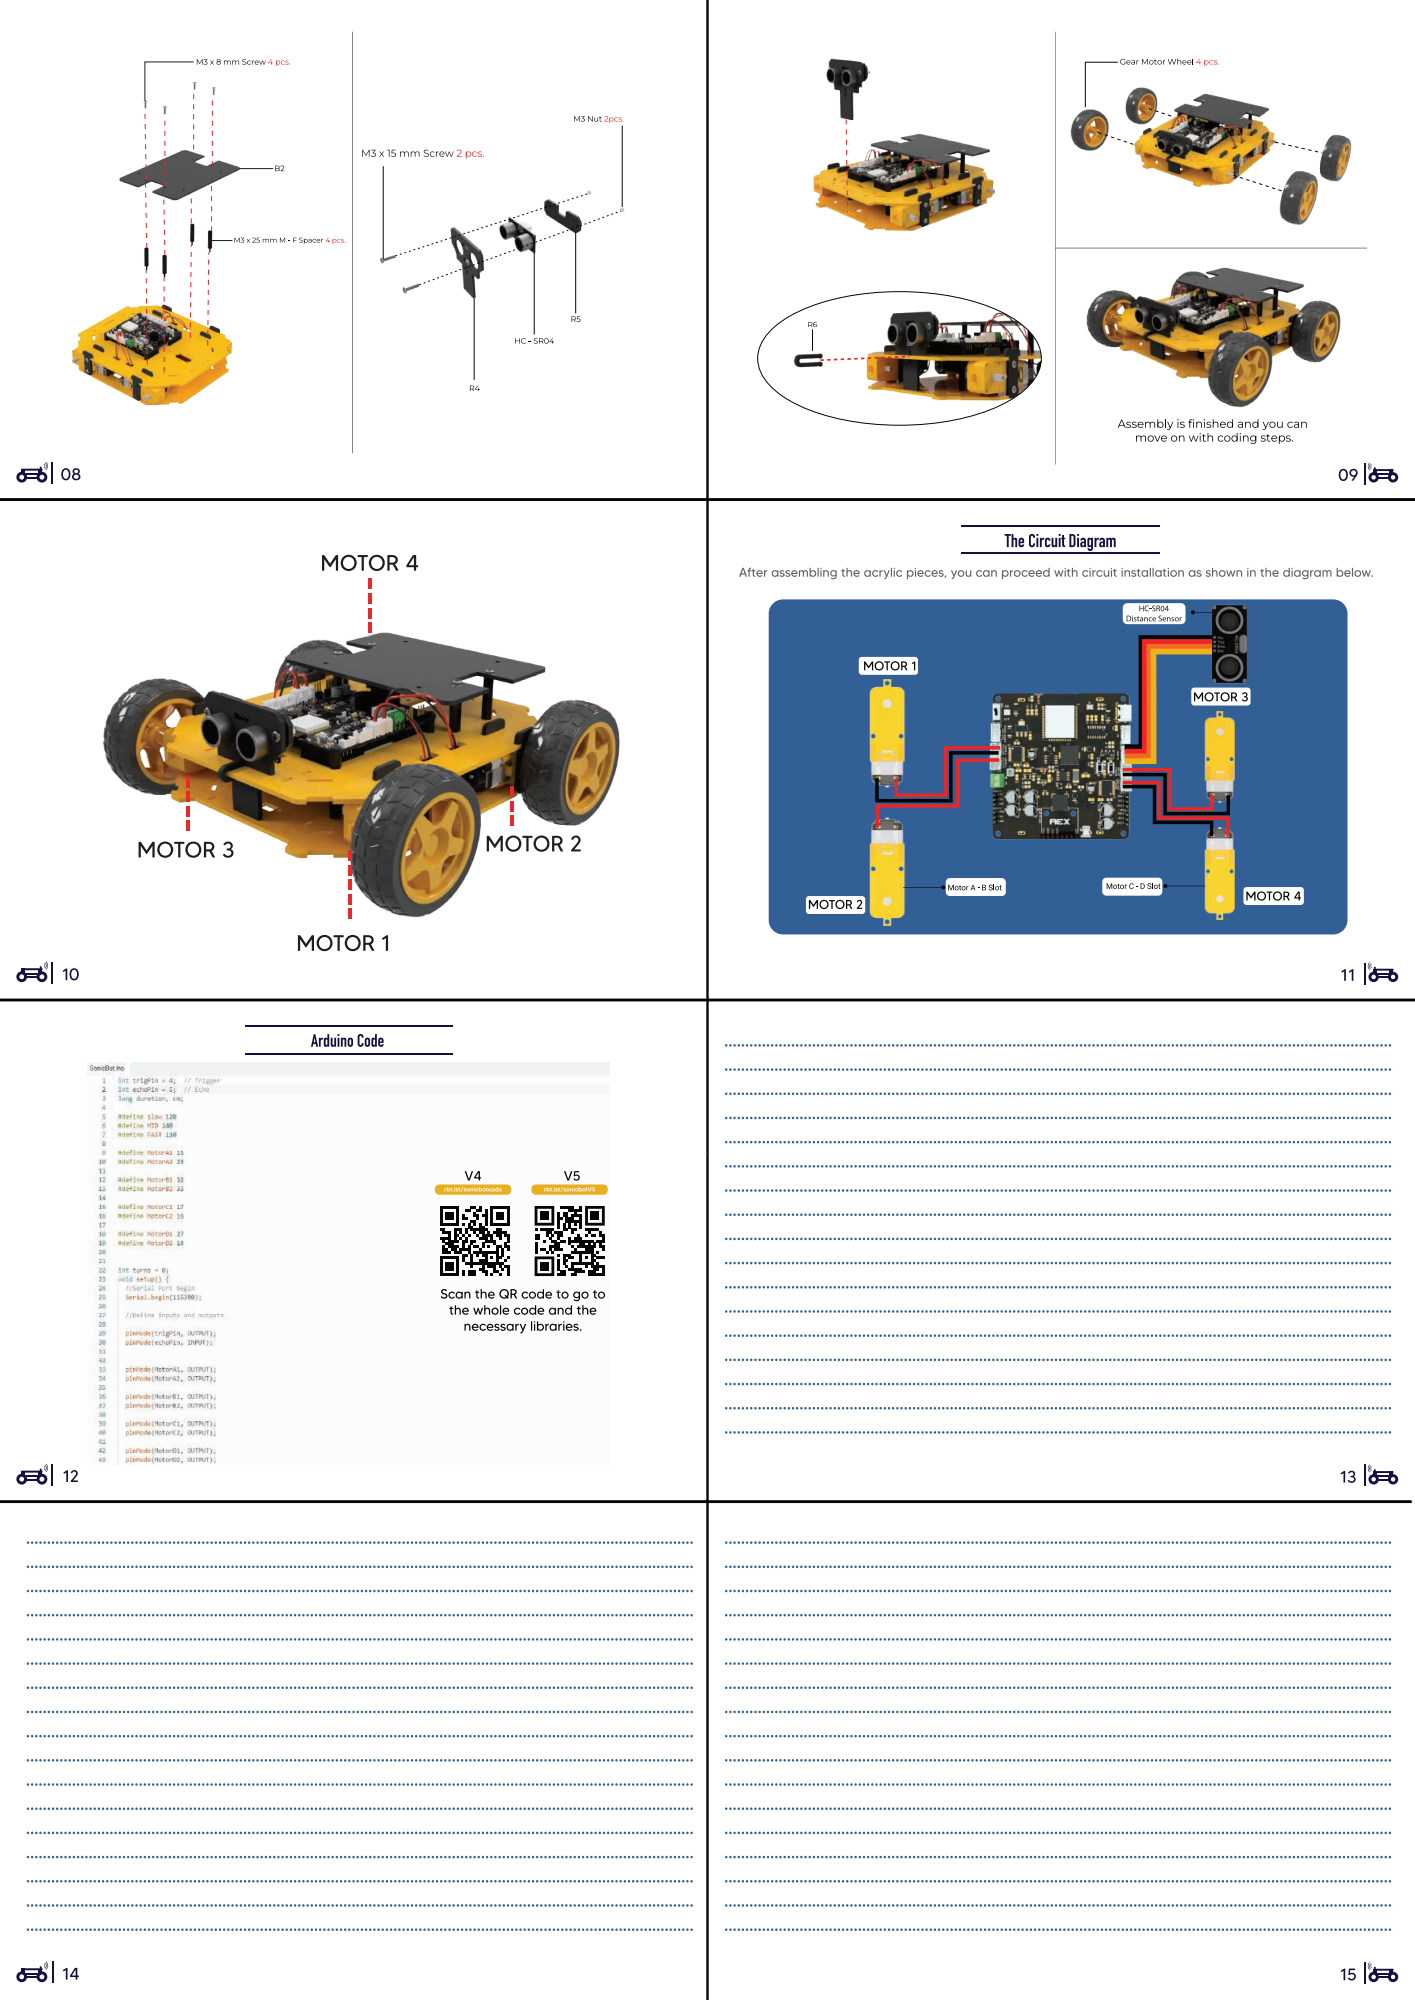
[picture p27: page 2]
