Robotistan/REX-8in1-V2/Installation Manuals/SumoBot.pdf

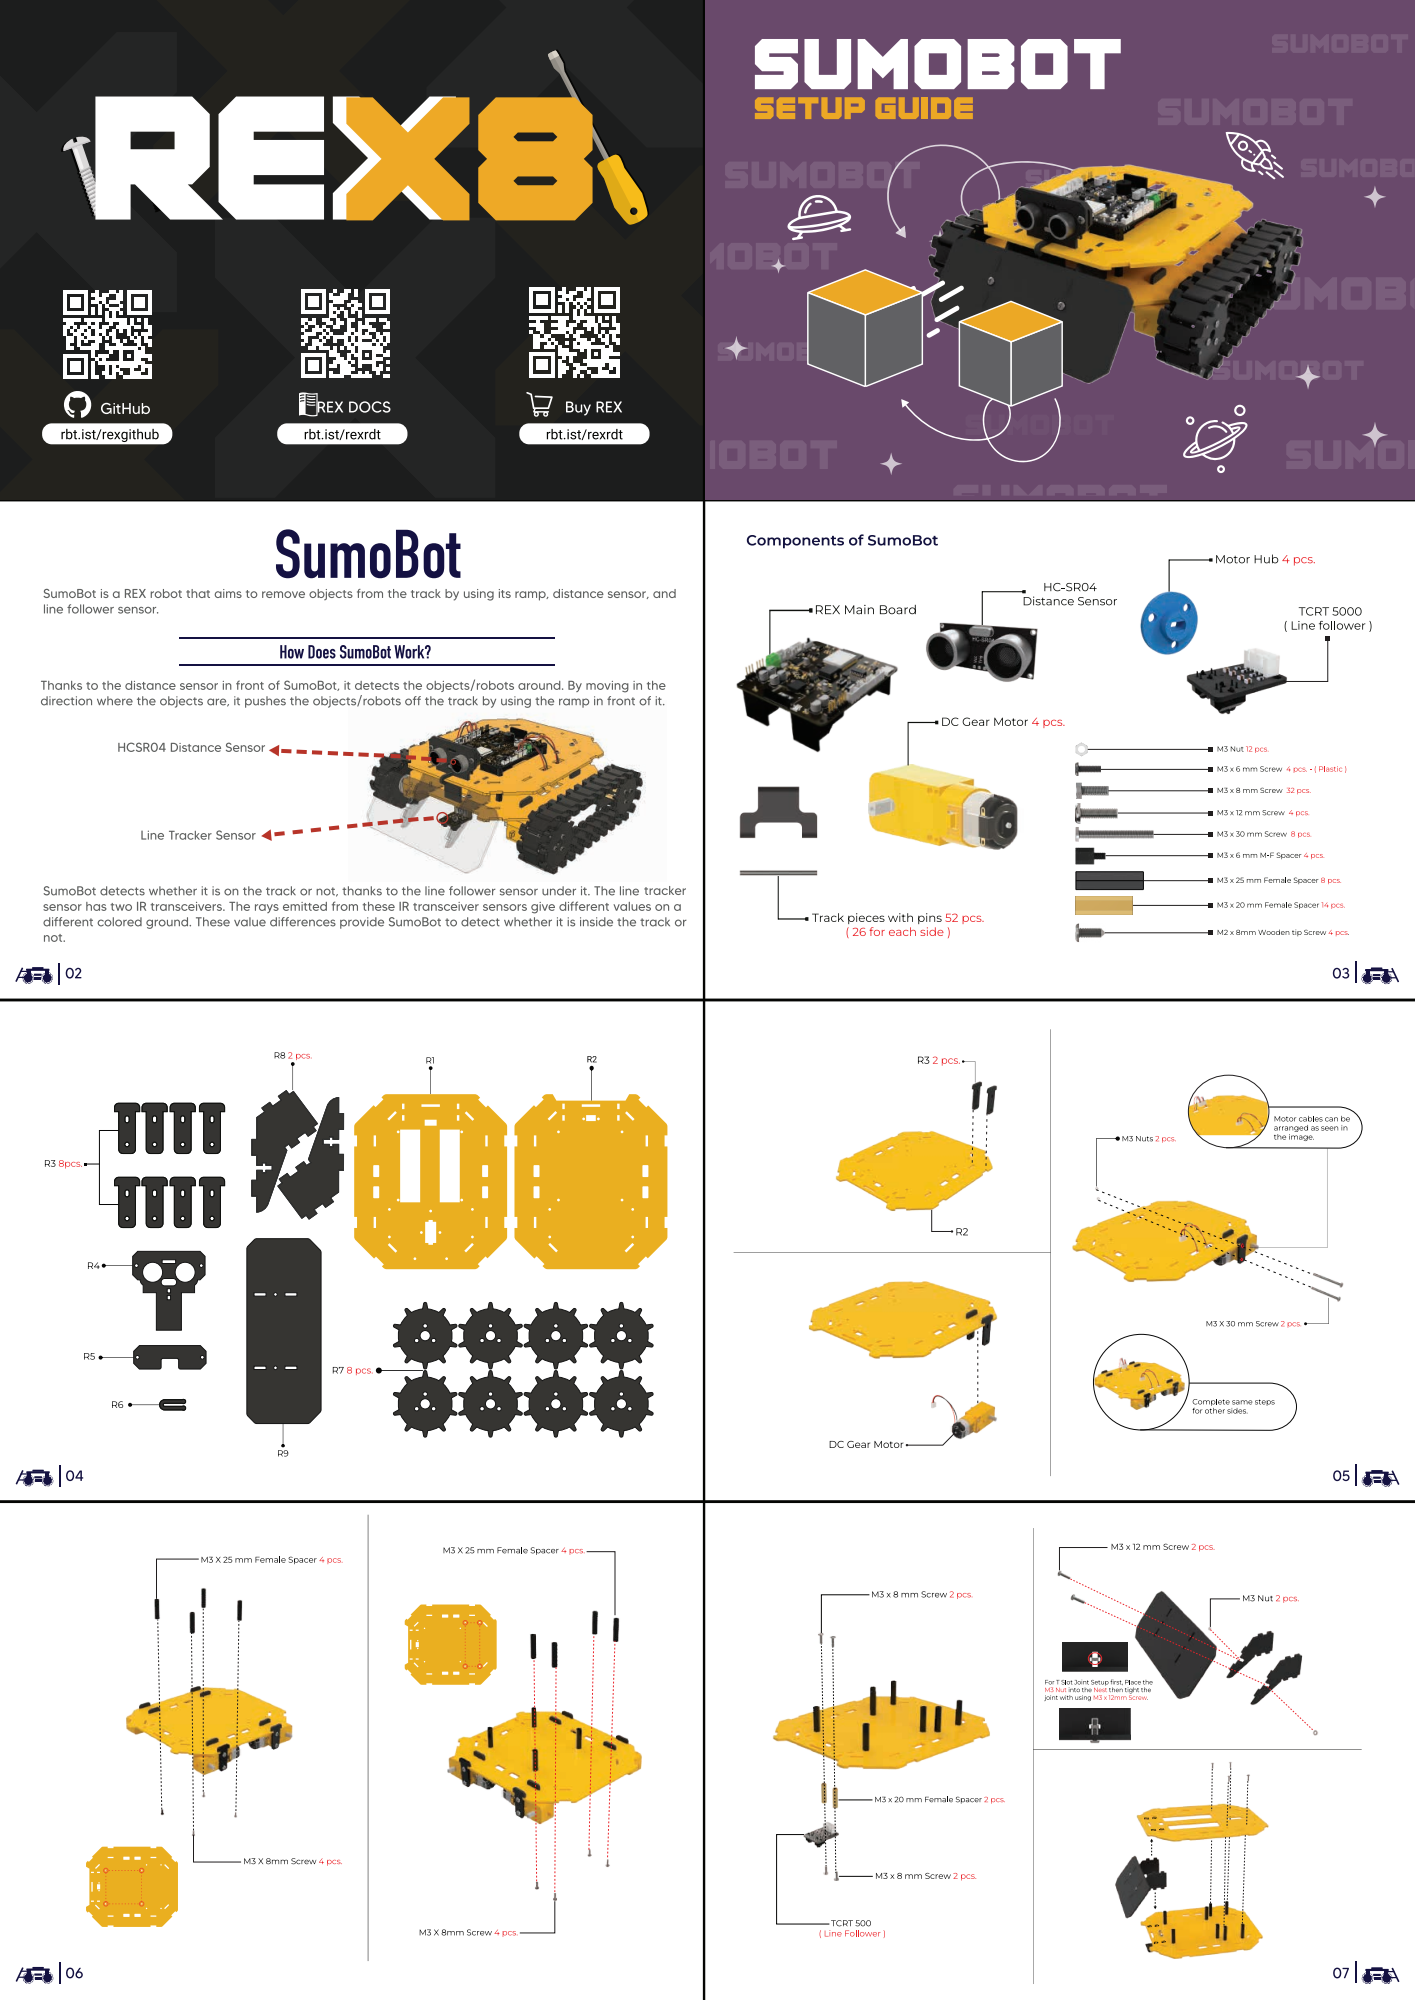
[picture p28: page 1]

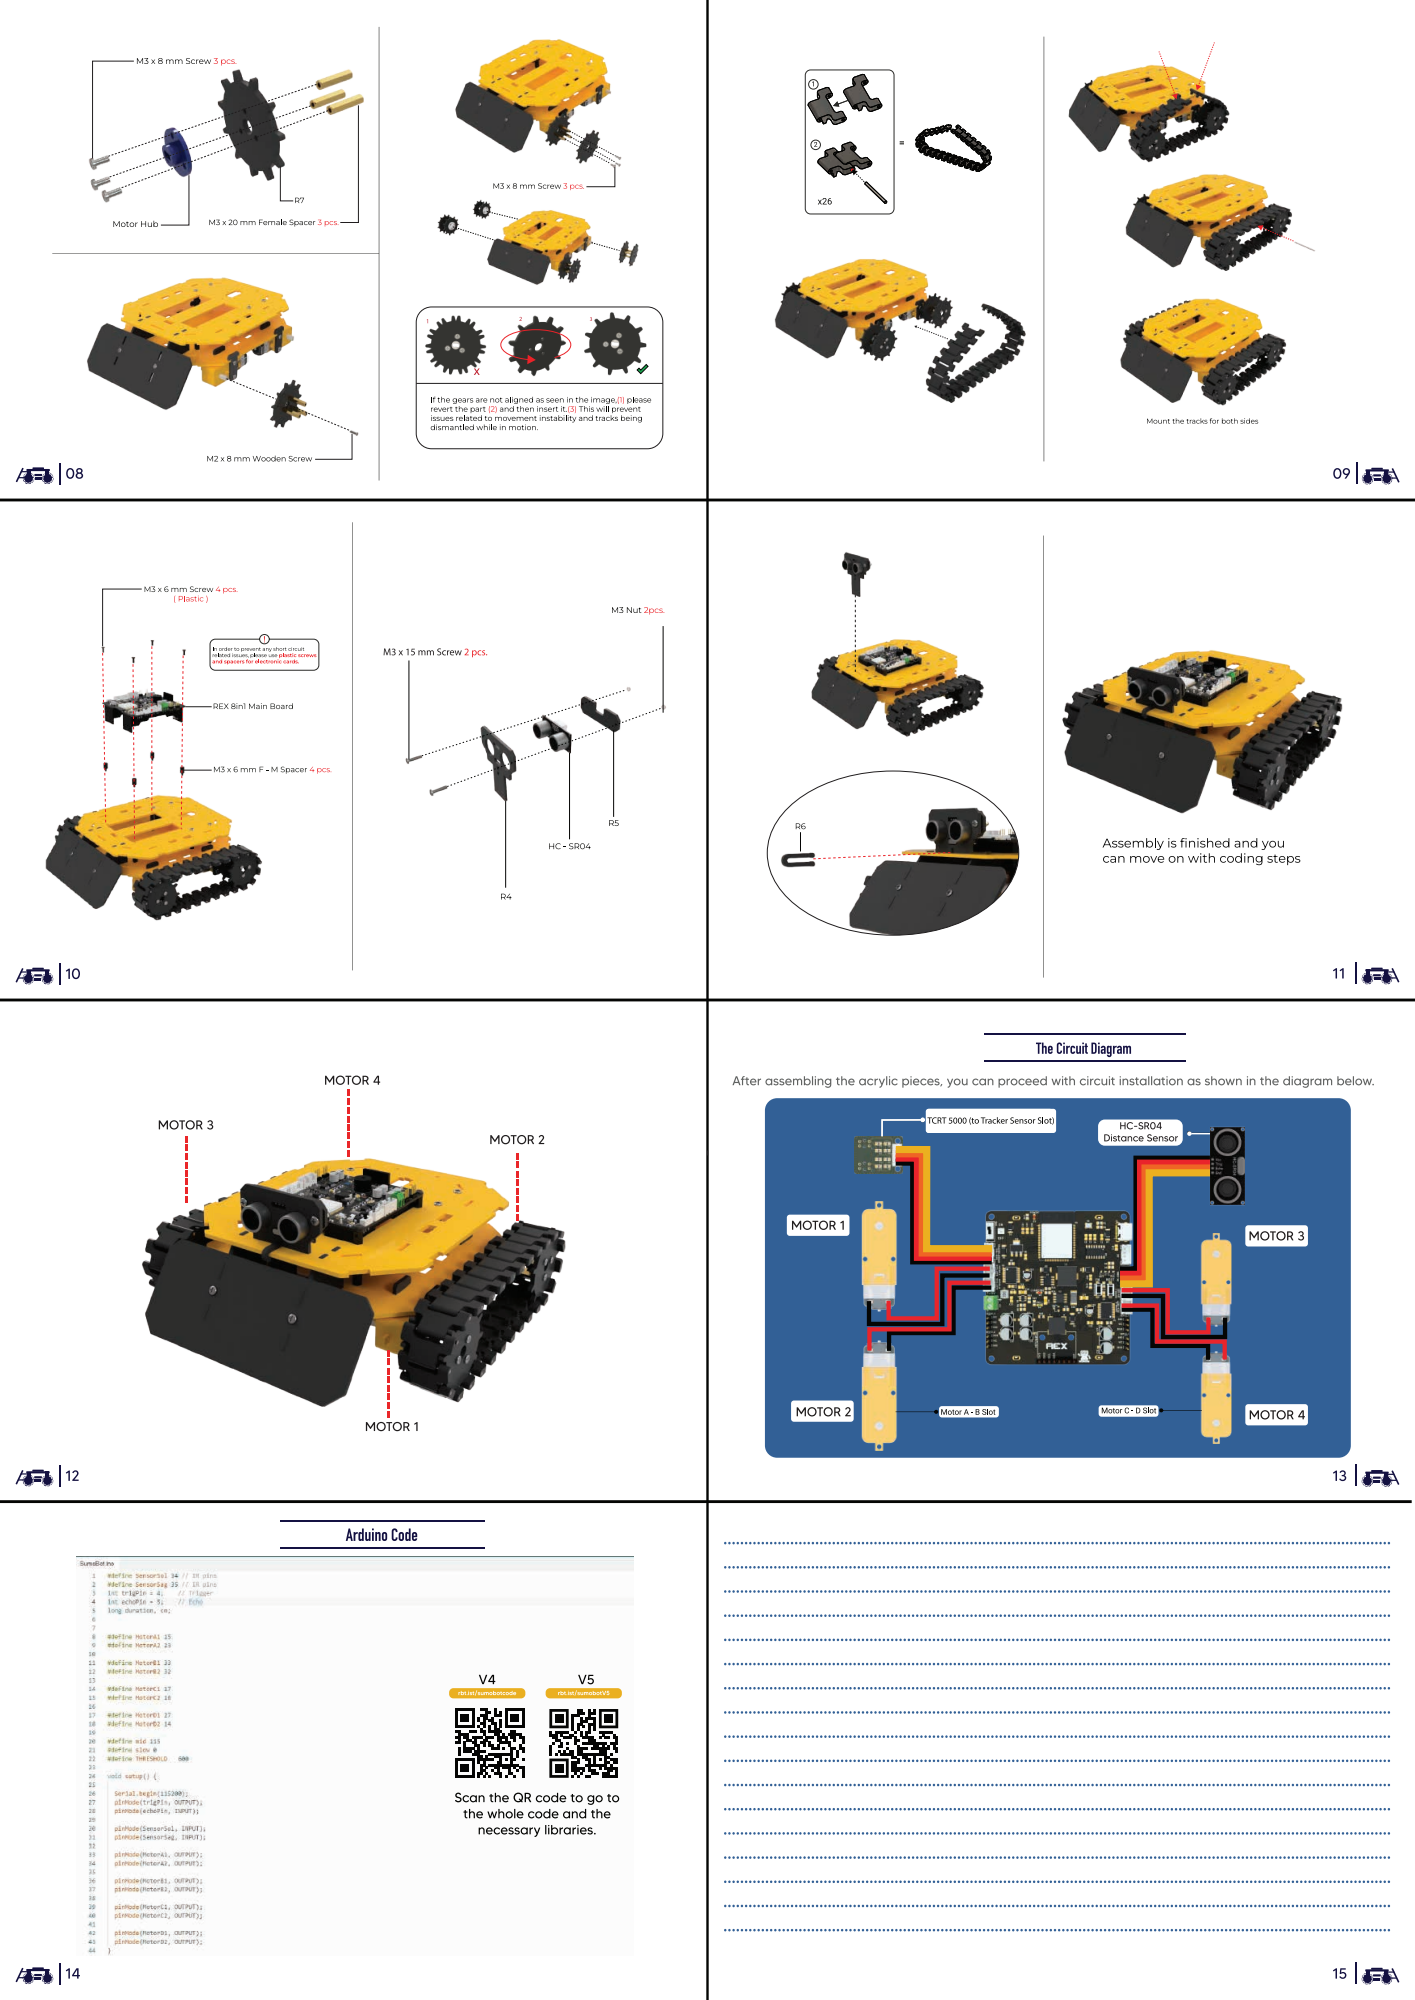
[picture p29: page 2]
