Robotistan/REX-8in1-V2/Installation Manuals/WiBot.pdf

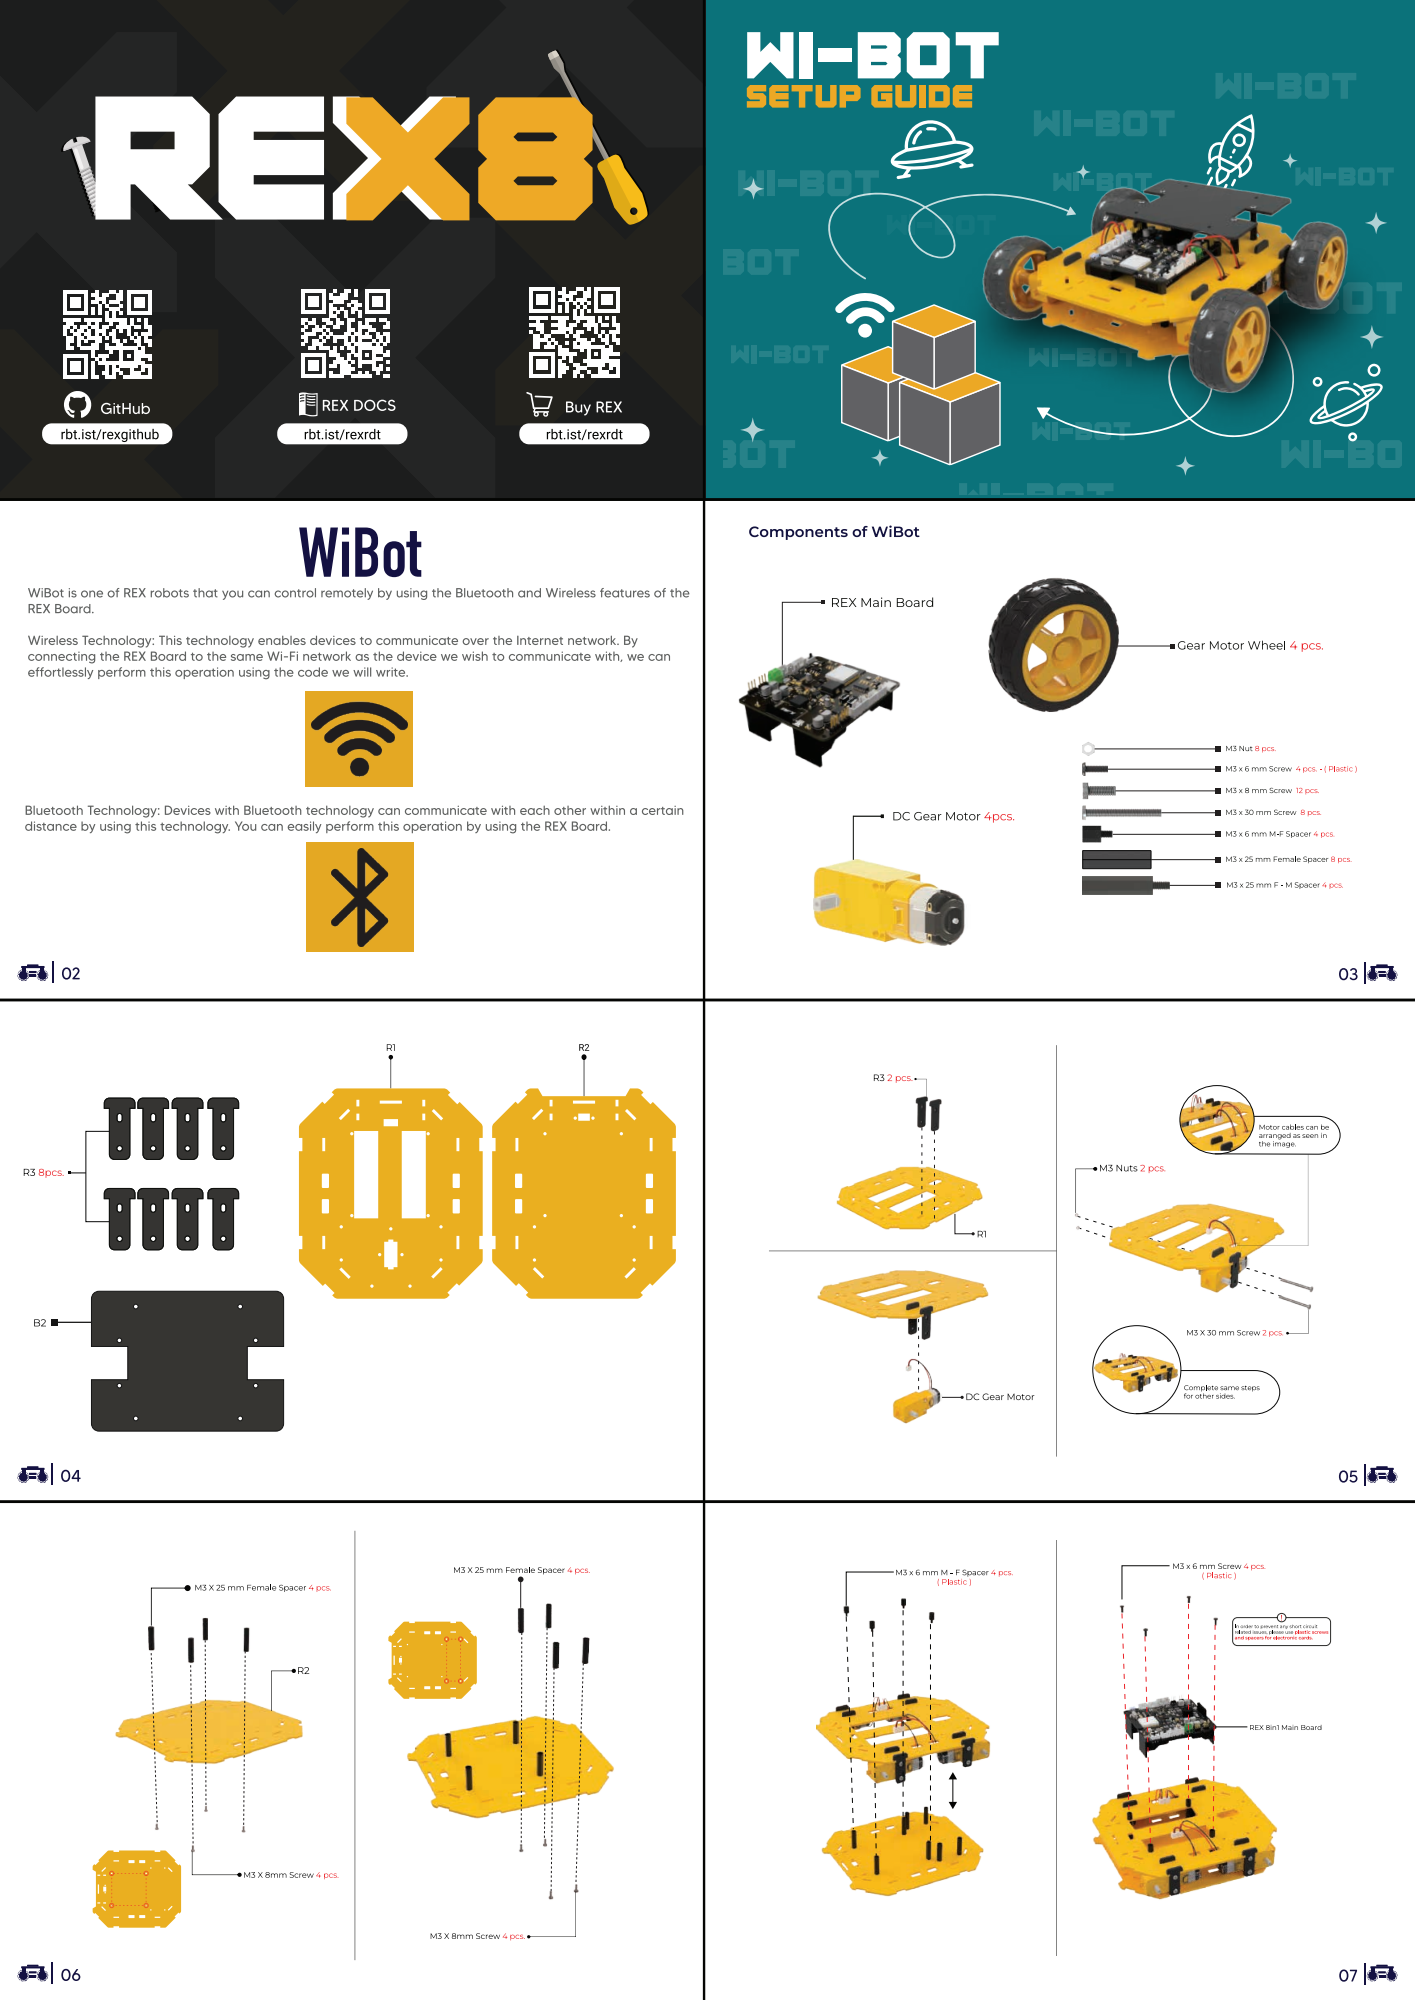
[picture p30: page 1]

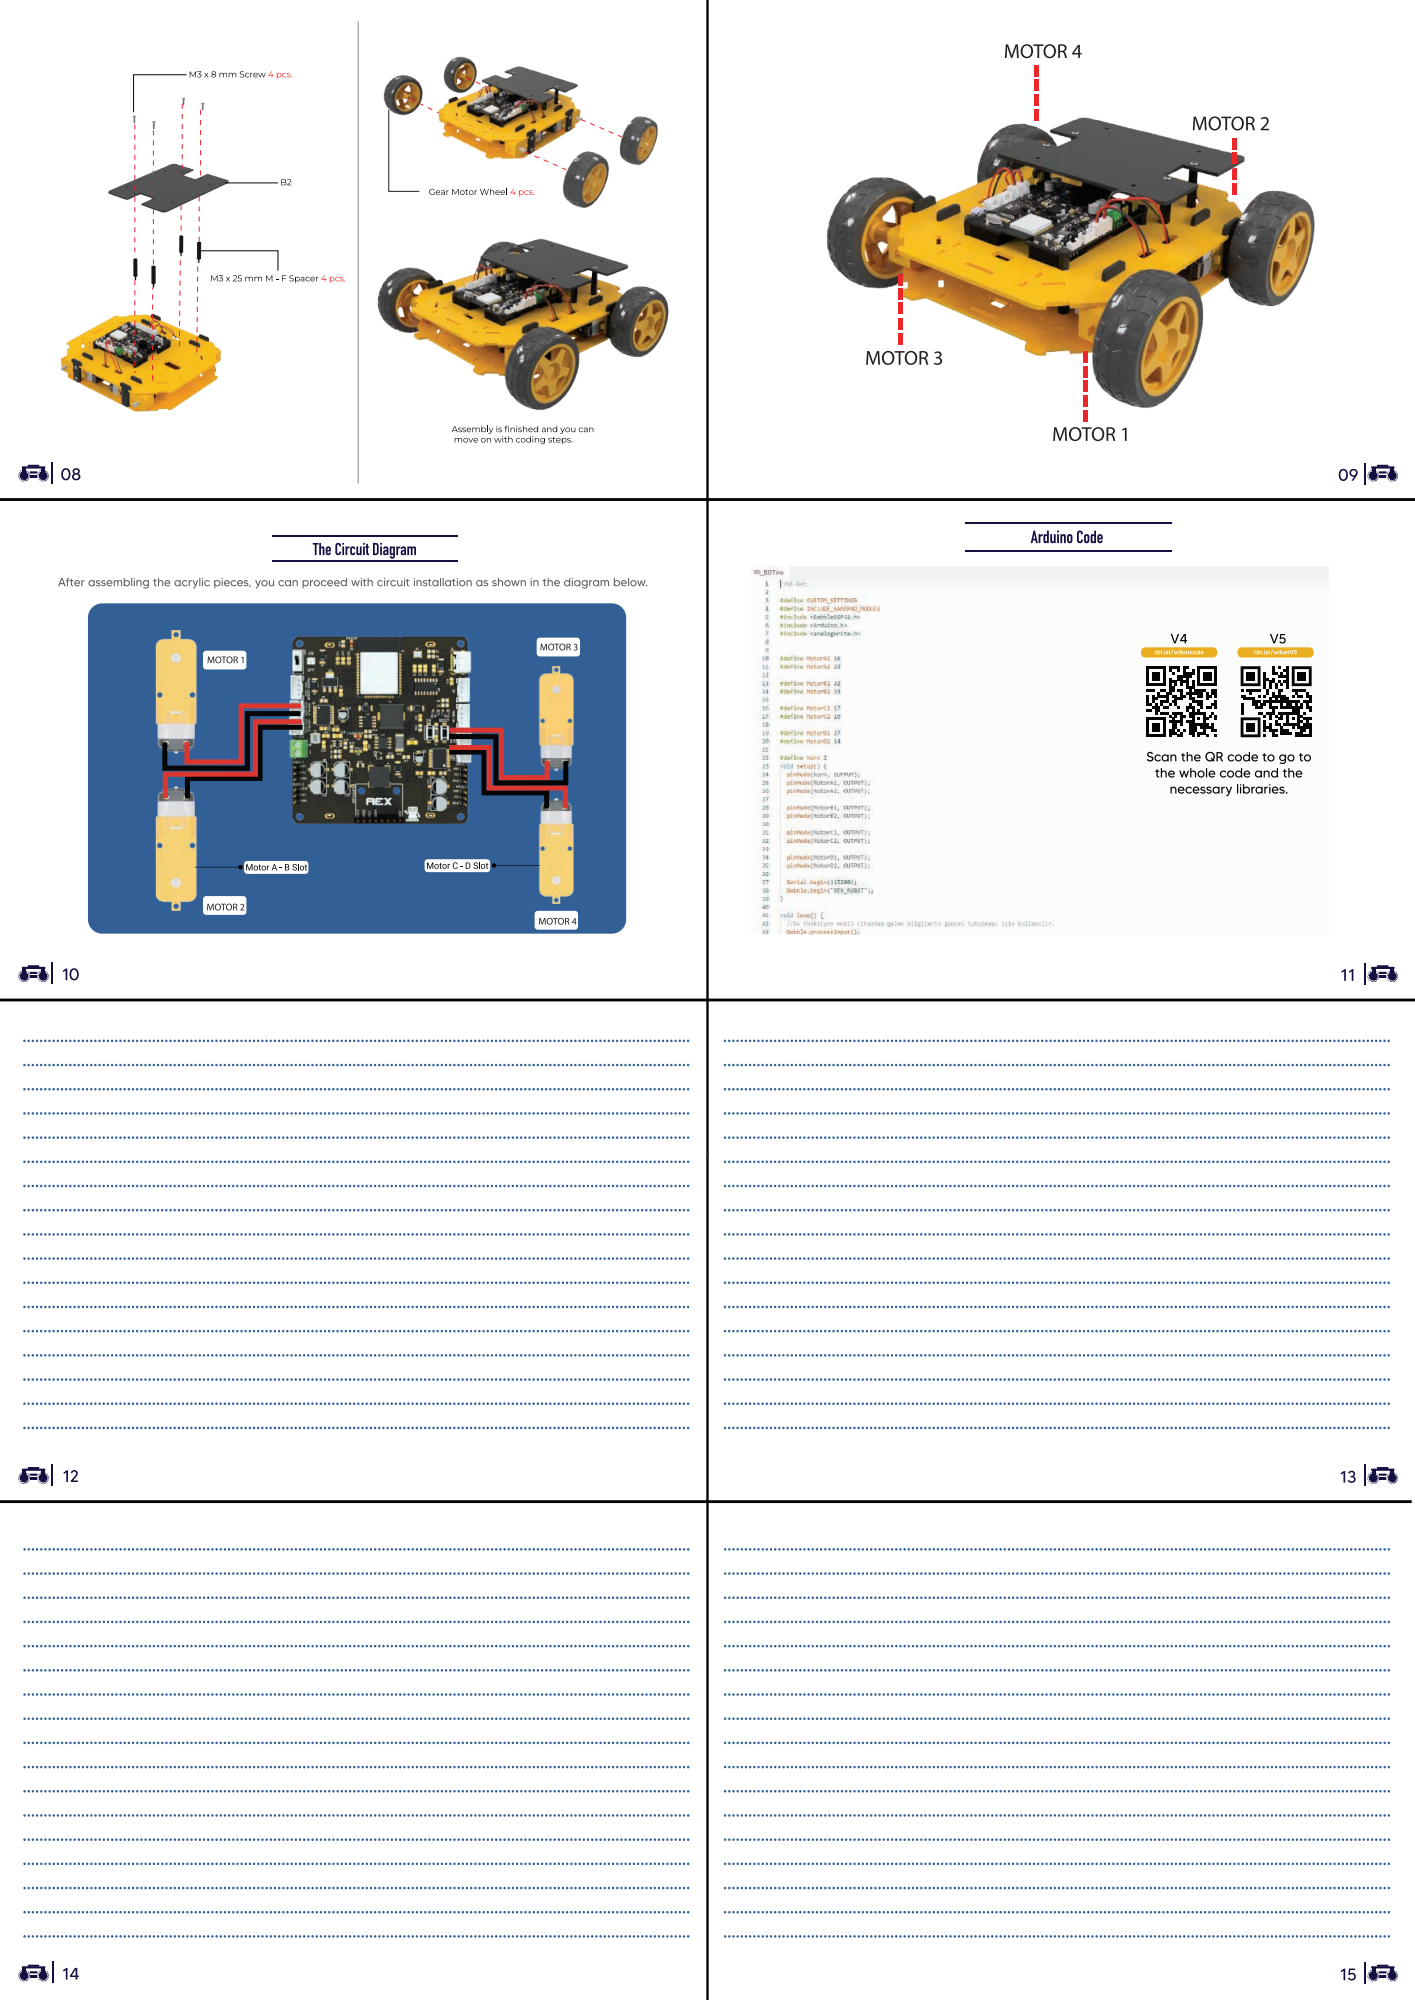
[picture p31: page 2]
