Robotistan/REX-8in1-V2/Installation Manuals/A3 Balance Bot KILAVUZ.pdf

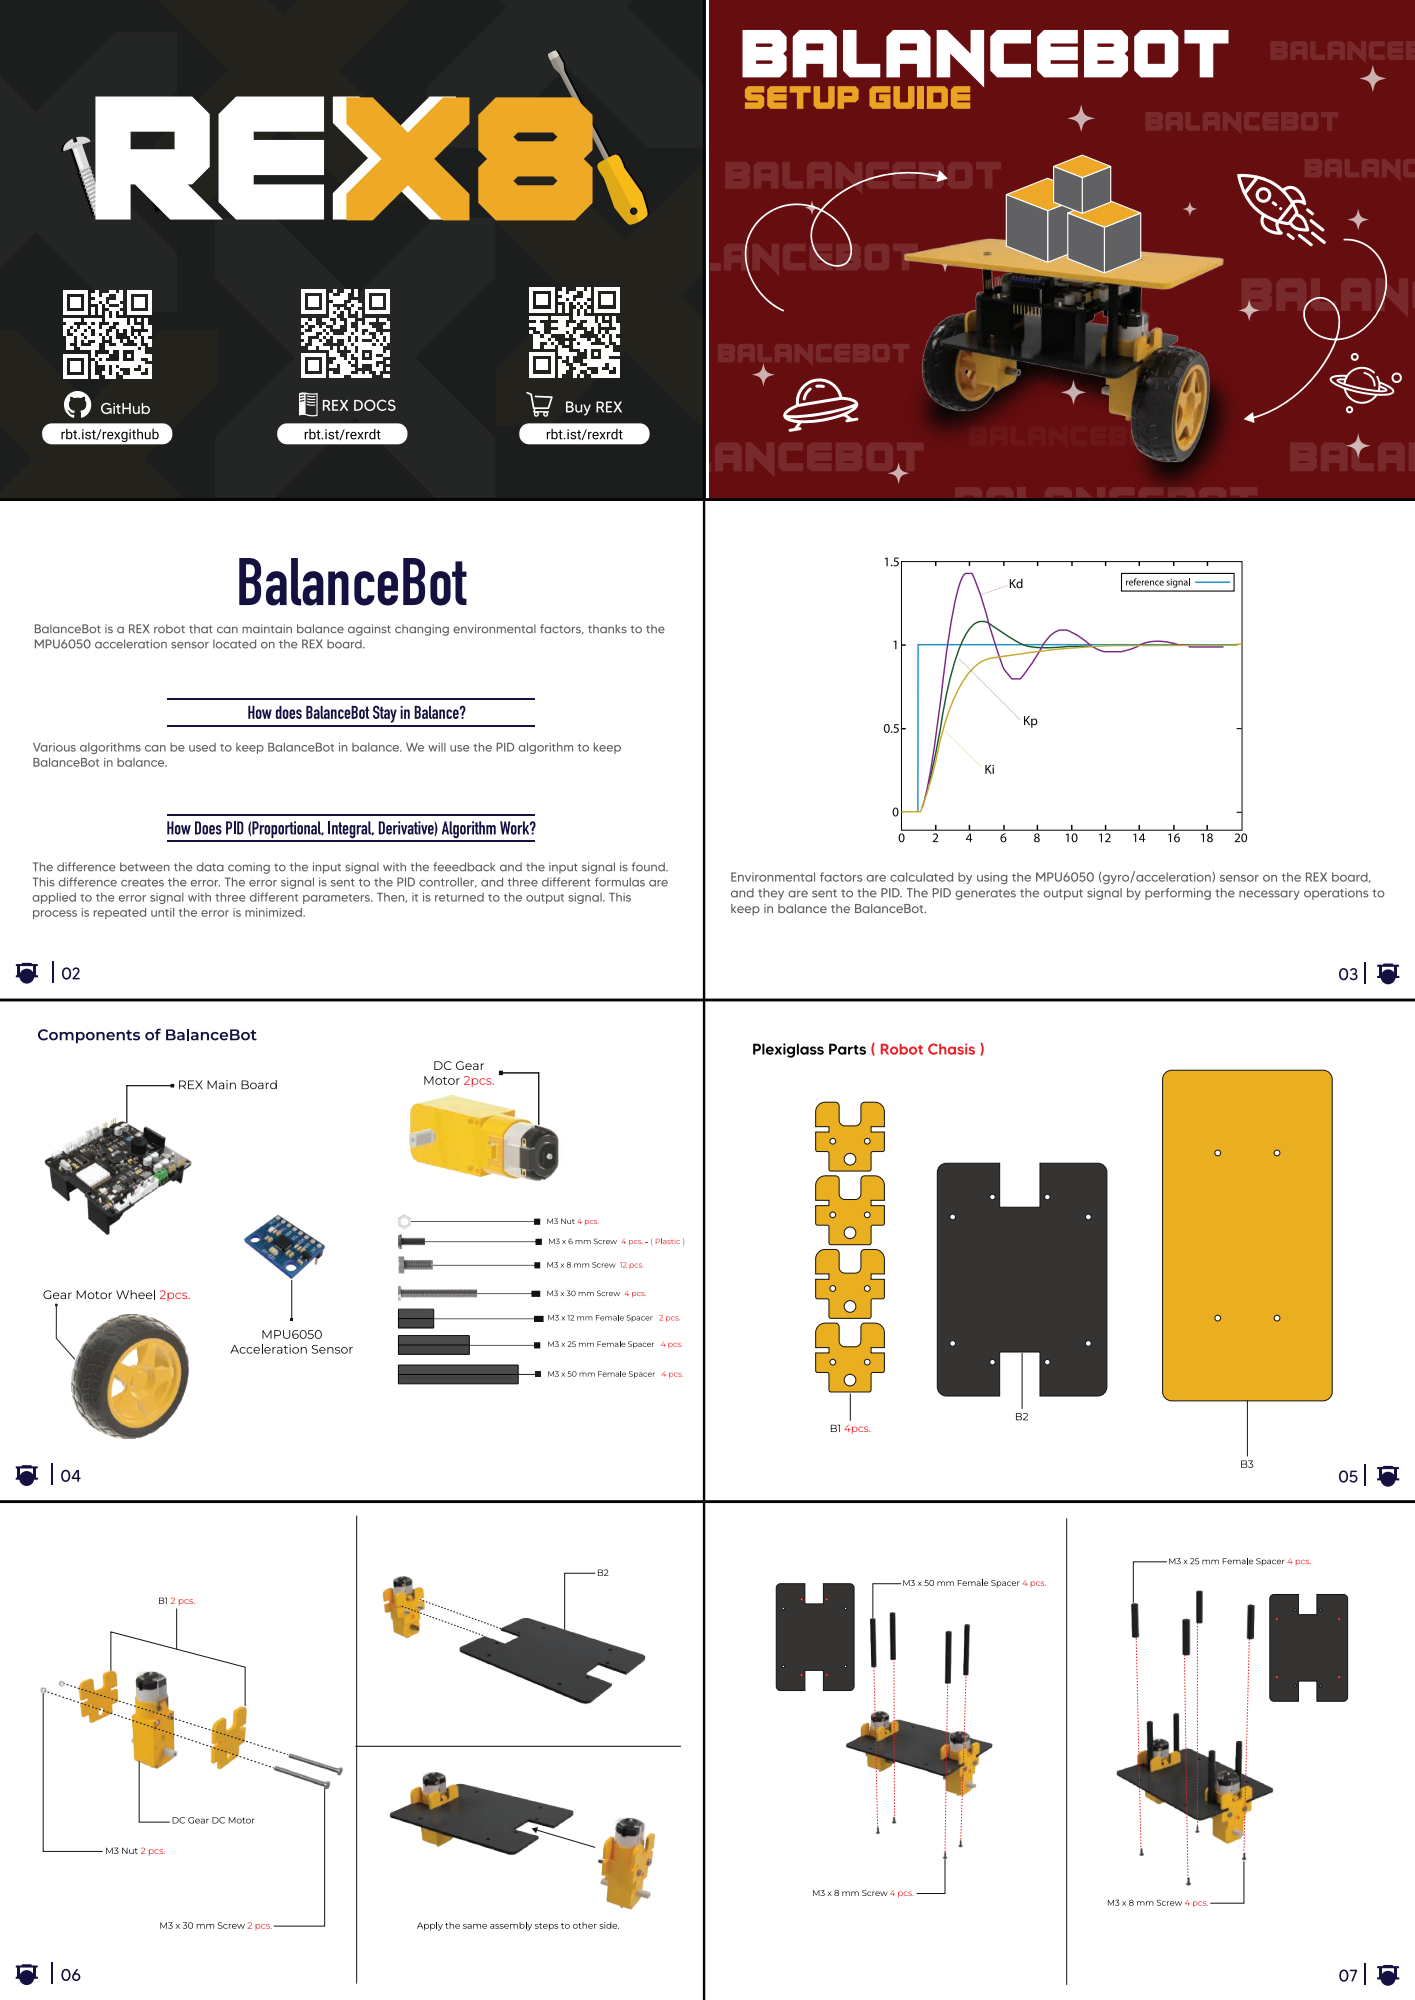
[picture p32: page 1]

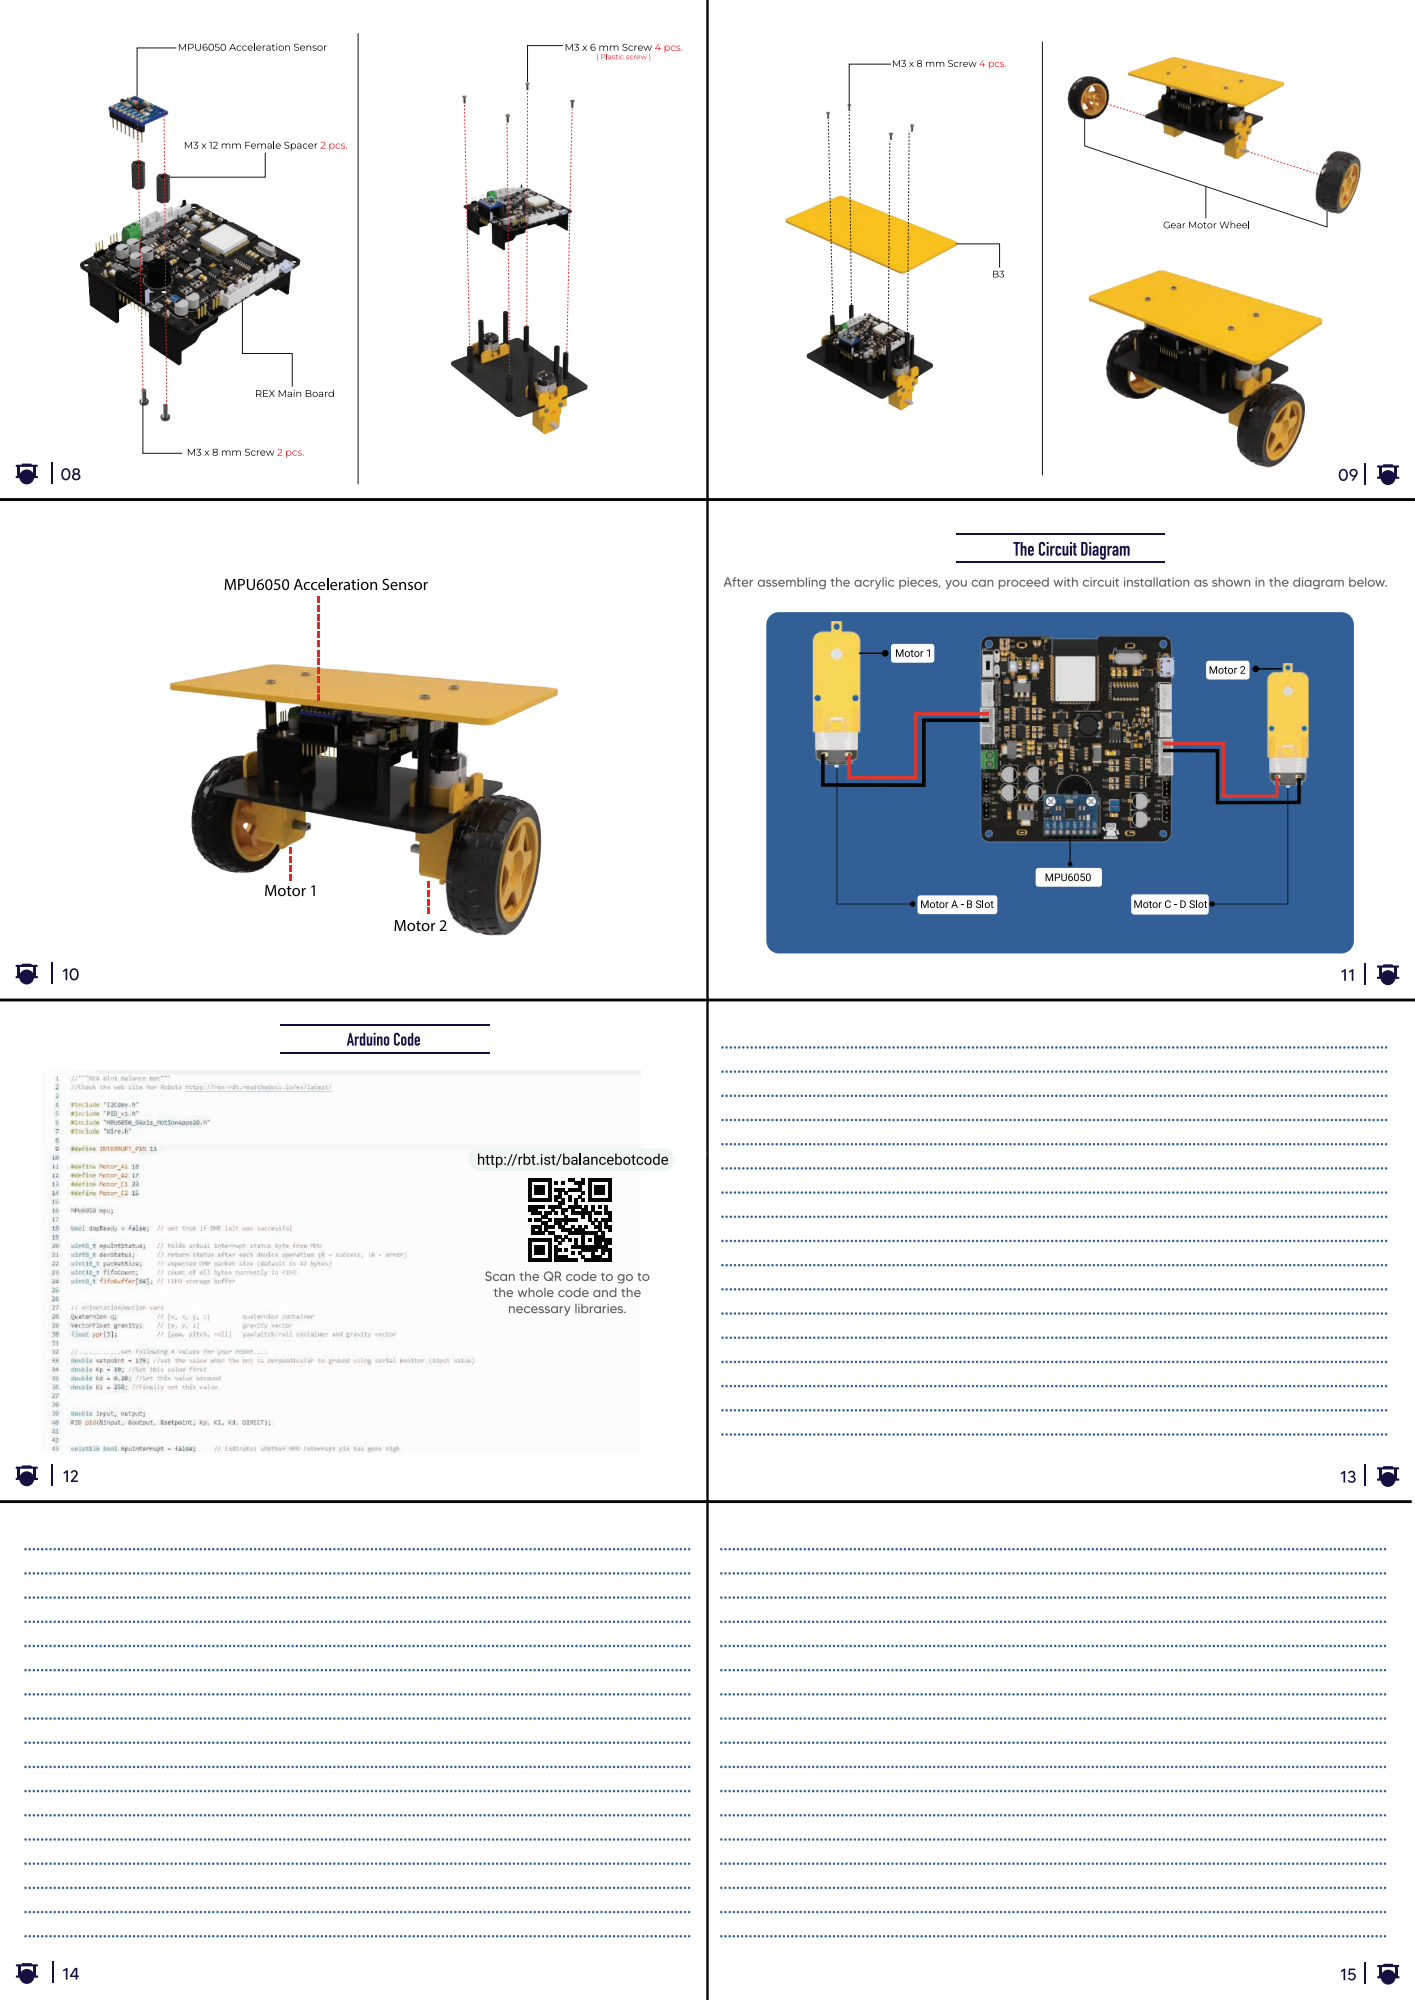
[picture p33: page 2]
