Robotistan/REX-8in1-V2/Installation Manuals/A3 OmniBot KILAVUZ.pdf

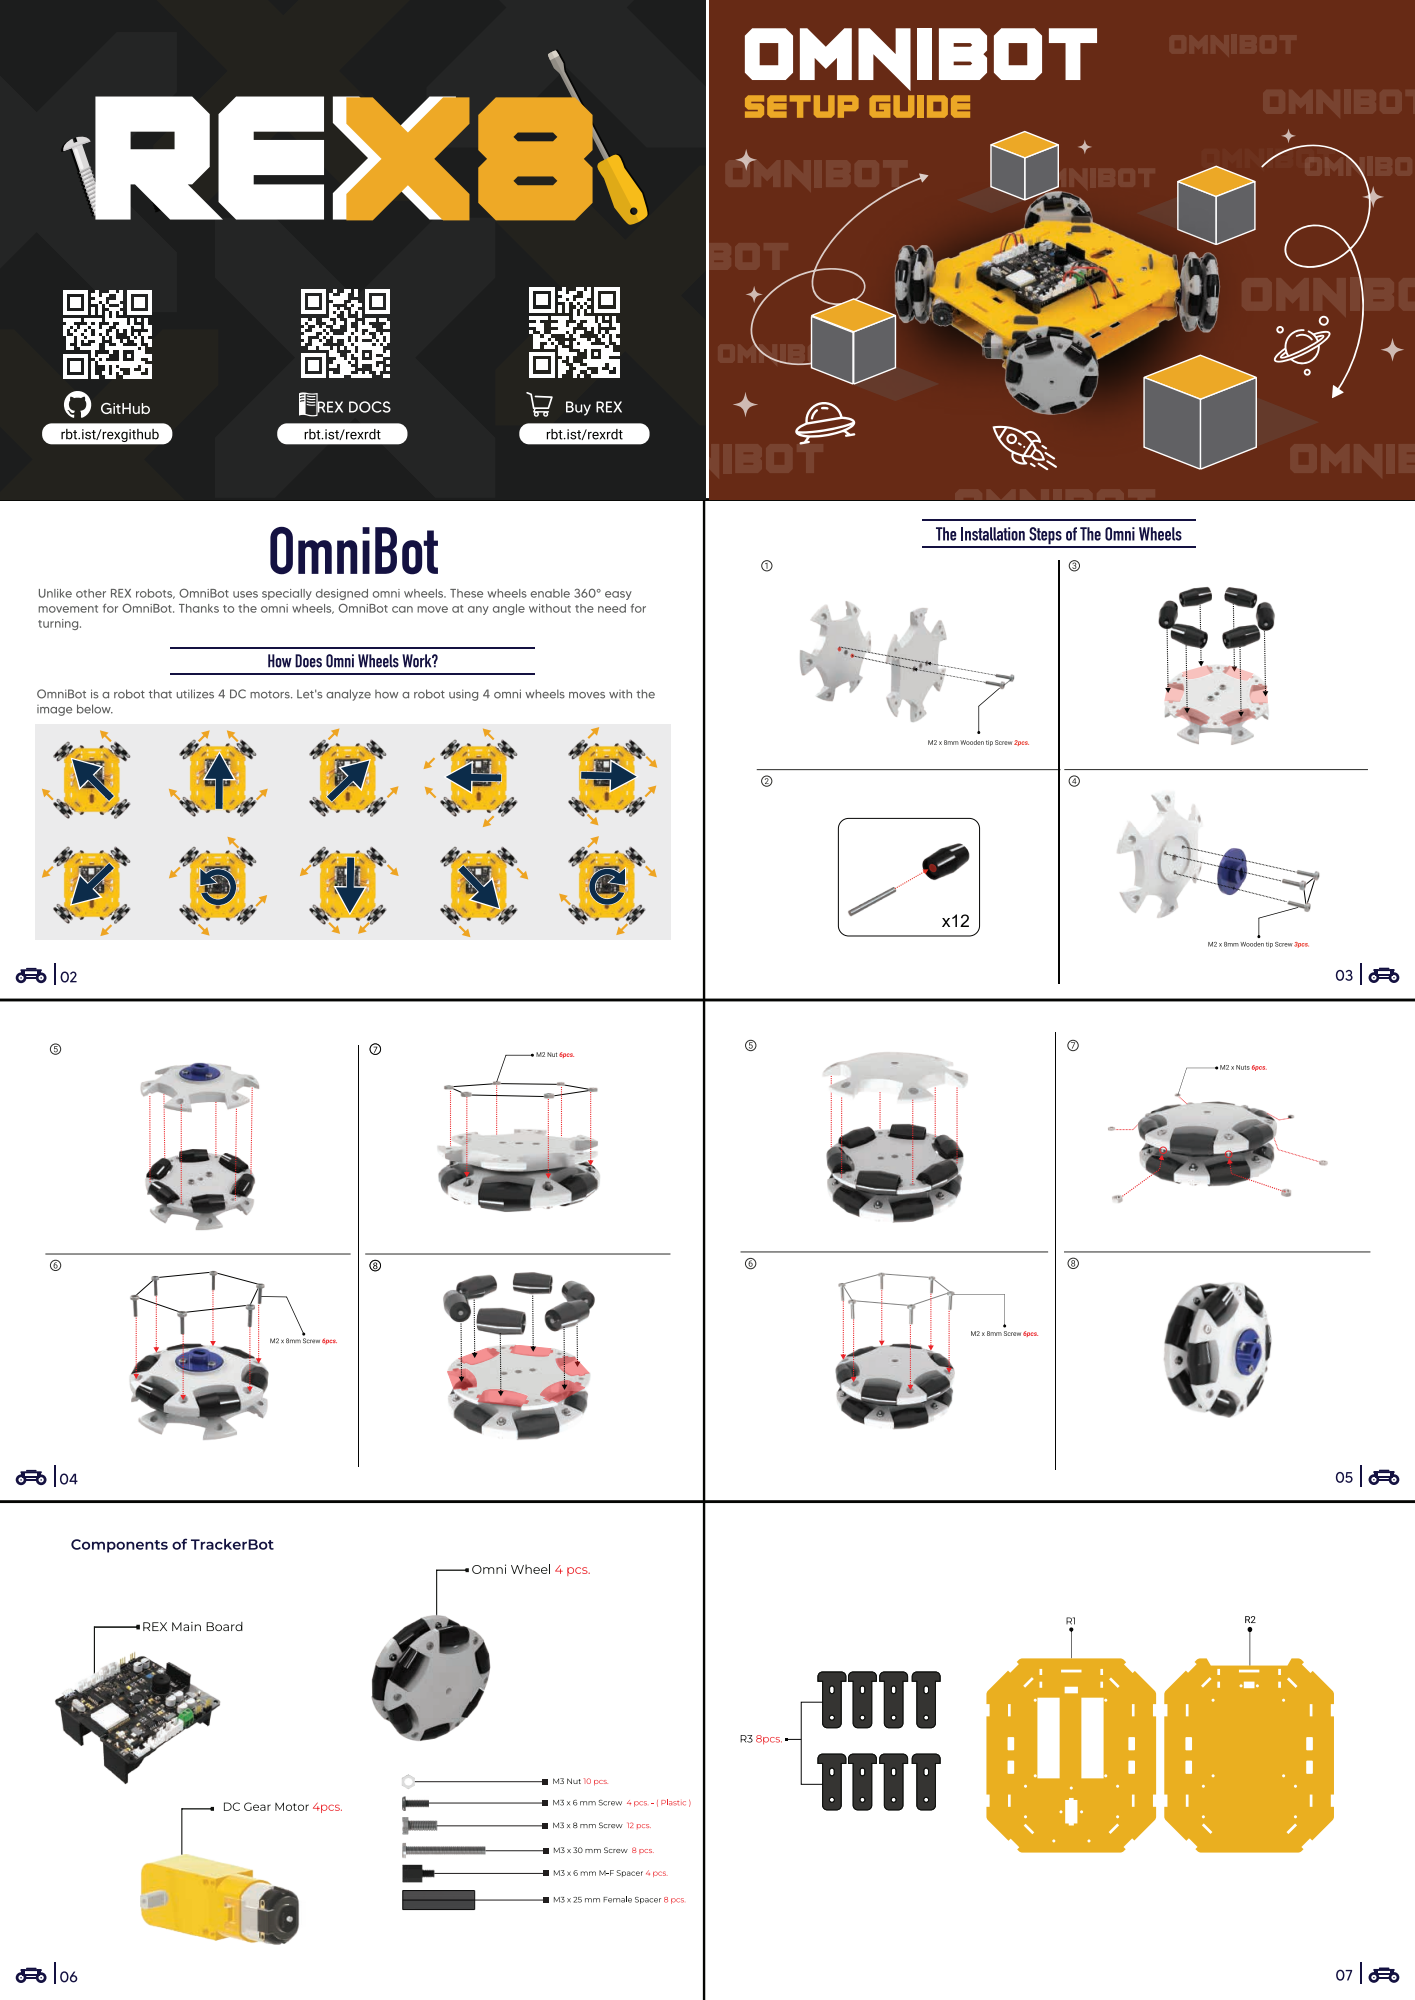
[picture p34: page 1]

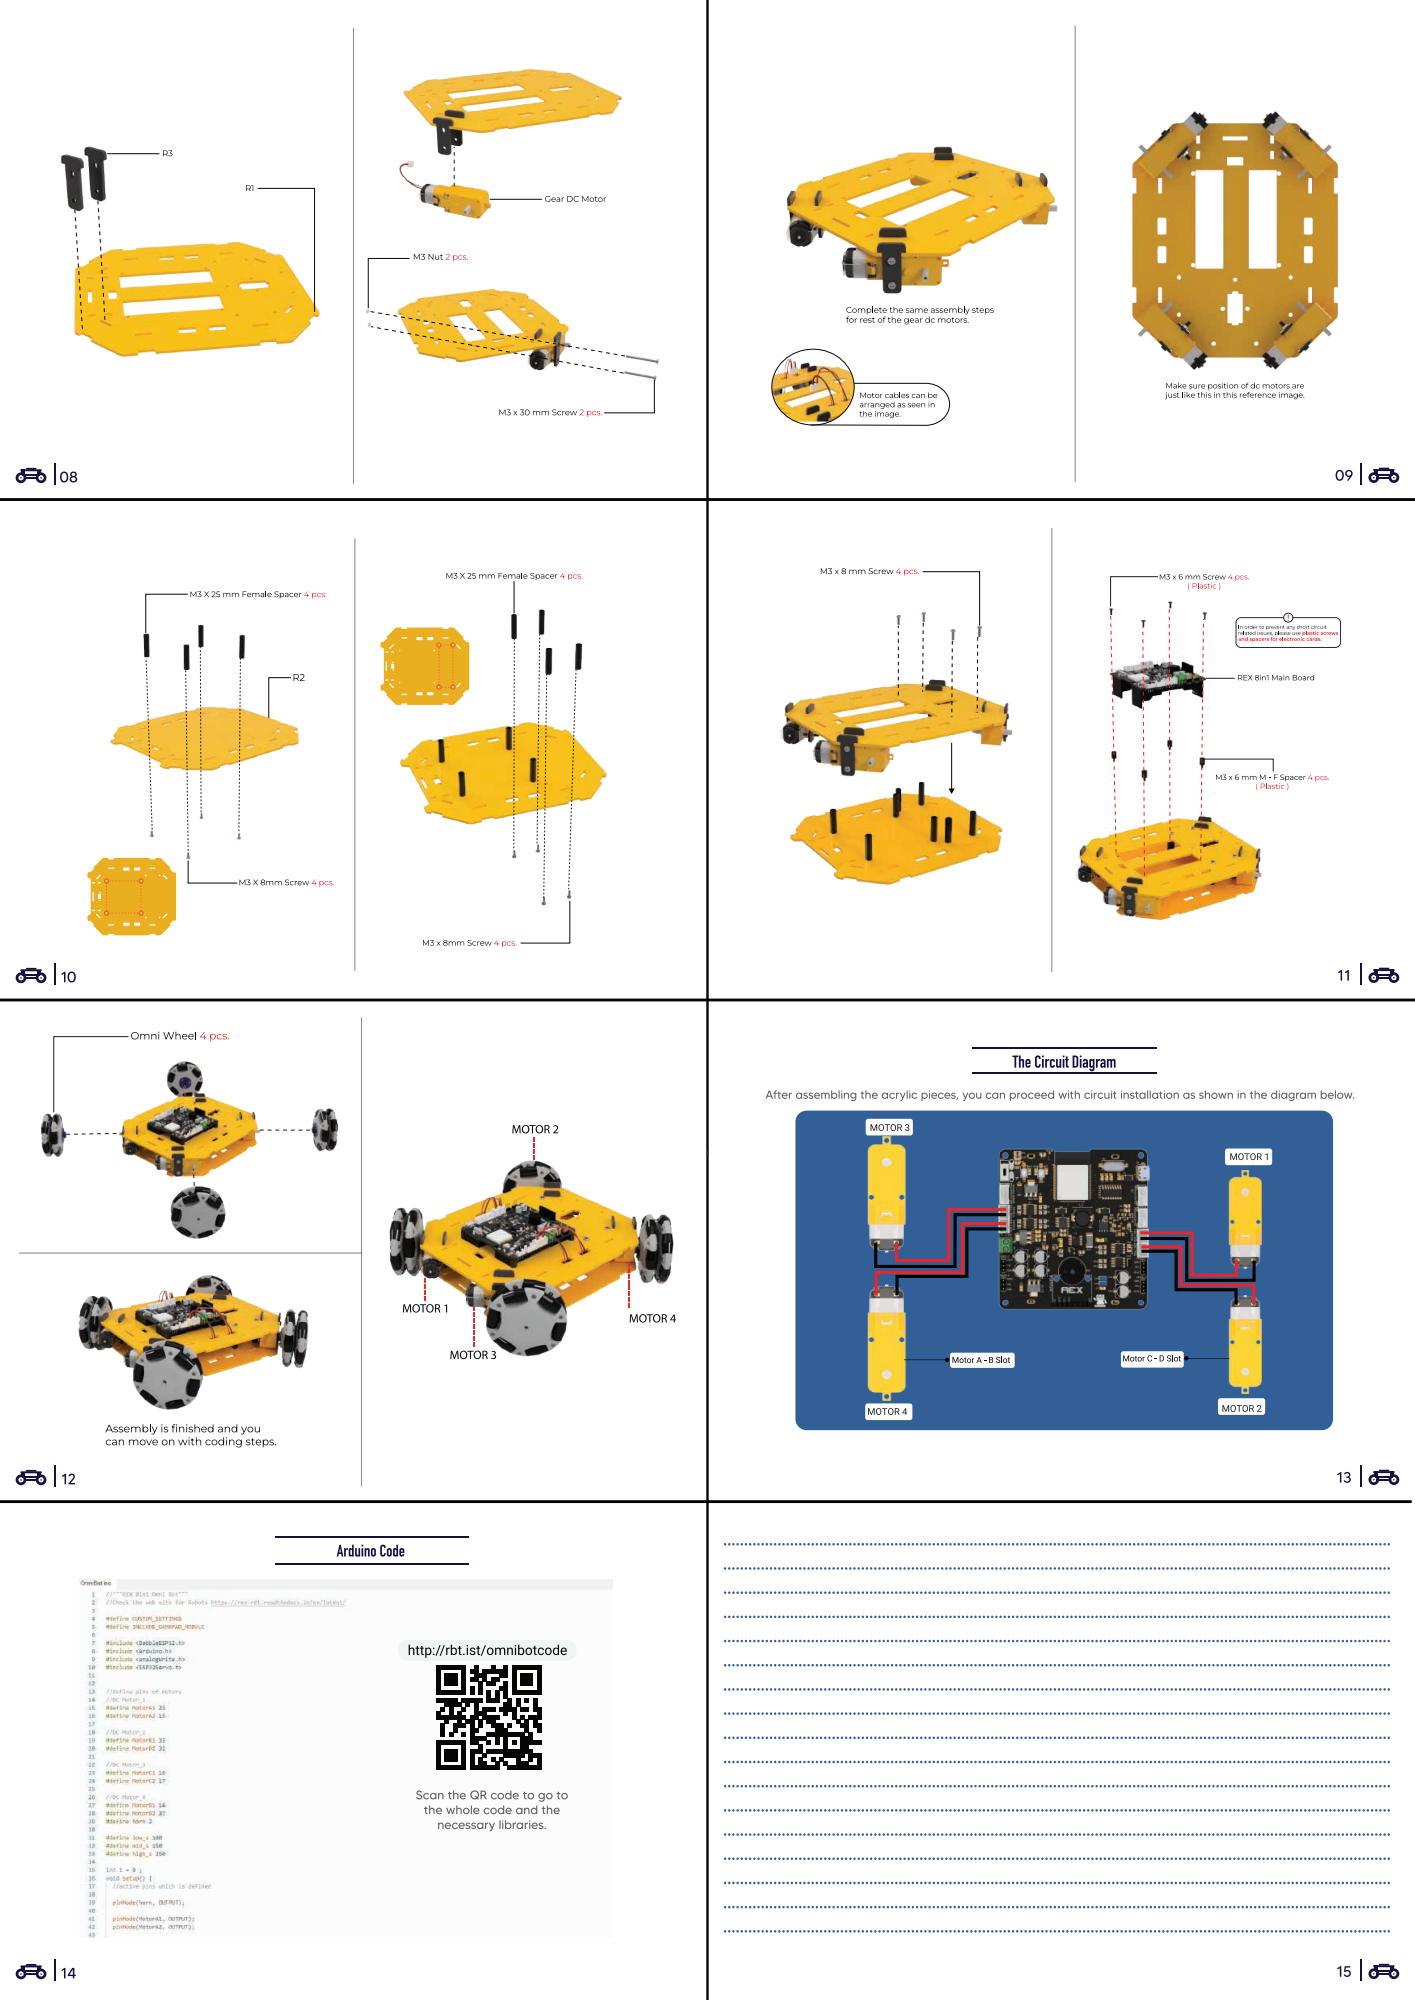
[picture p35: page 2]
