Robotistan/REX-8in1-V2/(commit log)

2026-03-09 Update ESP32 board version requirement in ArmBot.ino
2026-05-20 Swap buffer values for servo control logic
    [rex.ino]
